CRThu/CarrotController/stm32h563_controller_firmware/stm32h563_controller管脚定义和说明.md

## 板上管脚分配 

### KEY/LED 

| NAME | PIN | DIR | PIN | 
| - | - | - | - |
| KEYA | PF10  | I | 22 | 
| LEDA | PF08  |  O | 20 | 
| LEDB | PF09  |  O | 21 | 
 
### UART 
| NAME | PIN | DIR | PIN | 
| - | - | - | - |
| UART4_TX  | PB9 | IO | 140 | 
| UART4_RX  | PB8 | IO | 139 | 
 
### SPI 
| NAME | PIN | DIR | PIN | FUNC | DEFAULT |
| - | - | - | - | - | - |
| SPI4_NSS1 | PE4 |  O | 3 | R98: ESP32-S3<br/>R113: APS6404(U7) | ESP32-S3  |
| SPI4_NSS2 | PE3 |  O | 2 | R114: APS6404(U8) | CATLINK |
| SPI4_SCK  | PE2 |  O | 1 | SHARED | |
| SPI4_MISO | PE5 | I | 4 | SHARED | |
| SPI4_MOSI | PE6 |  O | 5 | SHARED | |

### IIC 
| NAME | PIN | DIR | PIN | 
| - | - | - | - |
| I2C1_SCL  | PB6 | IO | 136 | 
| I2C1_SDA  | PB7 | IO | 137 | 

### MUX 
 
| NAME | PIN | DIR | PIN | FUNC | DEFAULT | 
| - | - | - | - | - | - |
| MUX_SEL01 | PB15  |  O | 76 | BTB_CLK1 - MCU_PA01 | H | 
| MUX_SEL02 | PA08  |  O | 100 | BTB_CLK1 - SI5351_PLL1 | L | 
| MUX_SEL03 | PC09  |  O | 99 | BTB_CLK2 - MCU_PB03(SPI1_SCK) | L | 
| MUX_SEL04 | PC08  |  O | 98 | BTB_SPIA_SCK - MCU_PB03(SPI1_SCK) | H | 
| MUX_SEL05 | PB13  |  O | 74 | MCU_PB03(SPI1_SCK) - MCU_PC10(SPI3_SCK) | L | 
| MUX_SEL06 | PB14  |  O | 75 | BTB_SPIB_SCK - MCU_PC10(SPI3_SCK) | H | 
| MUX_SEL07 | PC05  |  O | 45 | BTB_CLK3 - MCU_PC02 | H | 
| MUX_SEL08 | PA05  |  O | 41 | BTB_CLK3 - SI5351_PLL2 | L | 
| MUX_SEL09 | PC13  |  O | 7 | BTB_CLK4 - MCU_PC03 | H | 
| MUX_SEL10 | PE00  |  O | 141 | BTB_CLK4 - SI5351_PLL3 | L | 
| MUX_SEL11 | PC15  |  O | 9 | BTB_CLK5 - MCU_PA02 | H | 
| MUX_SEL12 | PC14  |  O | 8 | BTB_CLK6 - MCU_PA03 | H | 
 
### FTDI 
 
| NAME | PIN | DIR | PIN | 
| - | - | - | - |
| FT_D0 | PF00  | IO | 10 | 
| FT_D1 | PF01  | IO | 11 | 
| FT_D2 | PF02  | IO | 12 | 
| FT_D3 | PF03  | IO | 13 | 
| FT_D4 | PF04  | IO | 14 | 
| FT_D5 | PF05  | IO | 15 | 
| FT_D6 | PF06  | IO | 18 | 
| FT_D7 | PF07  | IO | 19 | 
| FT_RDN	| PF13  |  O | 53 | 
| FT_RXFN	| PF11  | I | 49 | 
| FT_SIWUA	| PF15  |  O | 55 | 
| FT_TXEN	| PF12  | I | 50 | 
| FT_WRN	| PF14  |  O | 54 | 
 
## BTB管脚分配 
| BTB NAME | PIN | MCU PIN |
| - | - | - |
| CLK1	 | 11 | PA01* |
| CLK2	 | 13 | PA00 |
| CLK3	 | 12 | PC02* |
| CLK4	 | 14 | PC03* |
| CLK5	 | 18 | PA02* |
| CLK6	 | 20 | PA03* |
| SPIA_NSS/CS0  | 17 | PA04 |
| SPIA_SCK | 23 | PB03* |
| SPIA_MOSI | 25 | PB05 |
| SPIA_MISO | 27 | PB04 |
| SPIB_NSS/CS1  | 19 | PA15 |
| SPIB_SCK | 24 | PC10* |
| SPIB_MOSI | 26 | PC12 |
| SPIB_MISO | 28 | PC11 |
| CS2 | 32 | PC06 |
| CS3 | 31 | PC07 |
| D00 | 34 | PD00 |
| D01 | 36 | PD01 |
| D02 | 38 | PD02 |
| D03 | 40 | PD03 |
| D04 | 42 | PD04 |
| D05 | 44 | PD05 |
| D06 | 46 | PD06 |
| D07 | 48 | PD07 |
| D08 | 33 | PD08 |
| D09 | 35 | PD09 |
| D10 | 37 | PD10 |
| D11 | 39 | PD11 |
| D12 | 41 | PD12 |
| D13 | 43 | PD13 |
| D14 | 45 | PD14 |
| D15 | 47 | PD15 |
| RDL | 50 | PE13 |
| WRL | 52 | PE15 |
| RDH | 49 | PE12 |
| WRH | 51 | PE14 |
| UART_TXD | 55 | PA09 |
| UART_RXD | 57 | PA10 |
| IIC_SDA | 56 | PB12 |
| IIC_SCL | 58 | PB10 |
