CRThu/CarrotController/PCB/PCB.stm32h563_controller_mini.Ver.A.pdf

# R48 R⁴⁹

# R261 R²⁶²

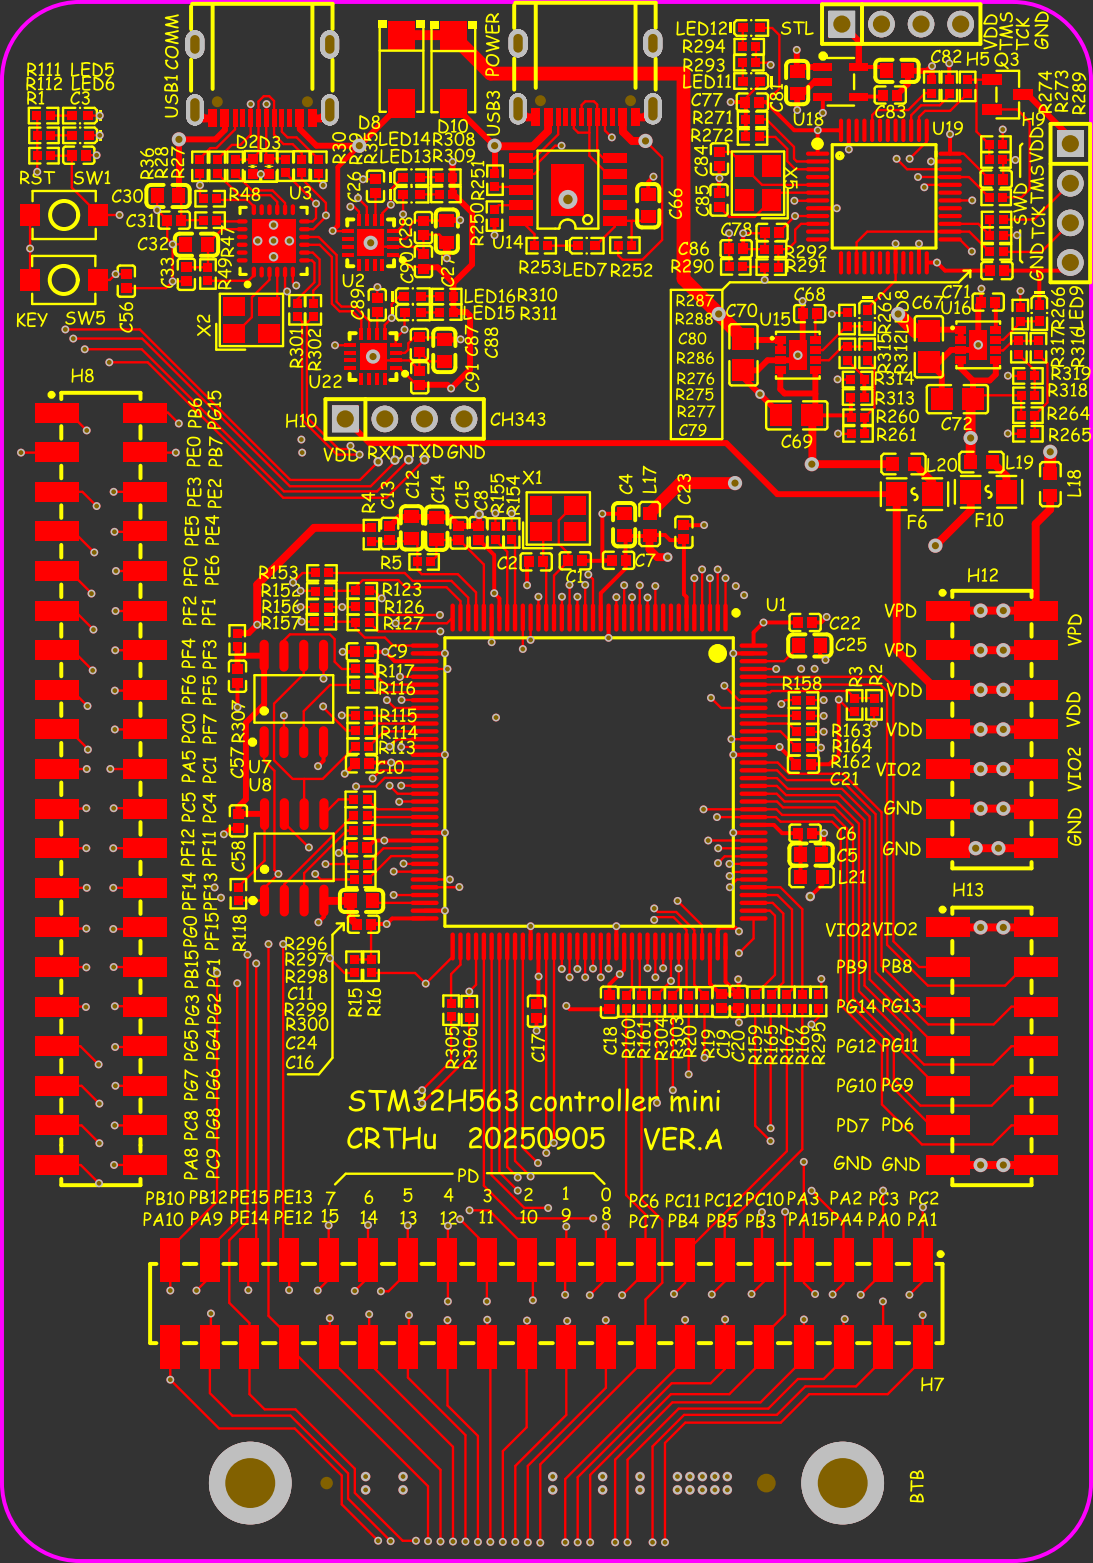
[picture p1: page 1]

VDD TMS TCK GND

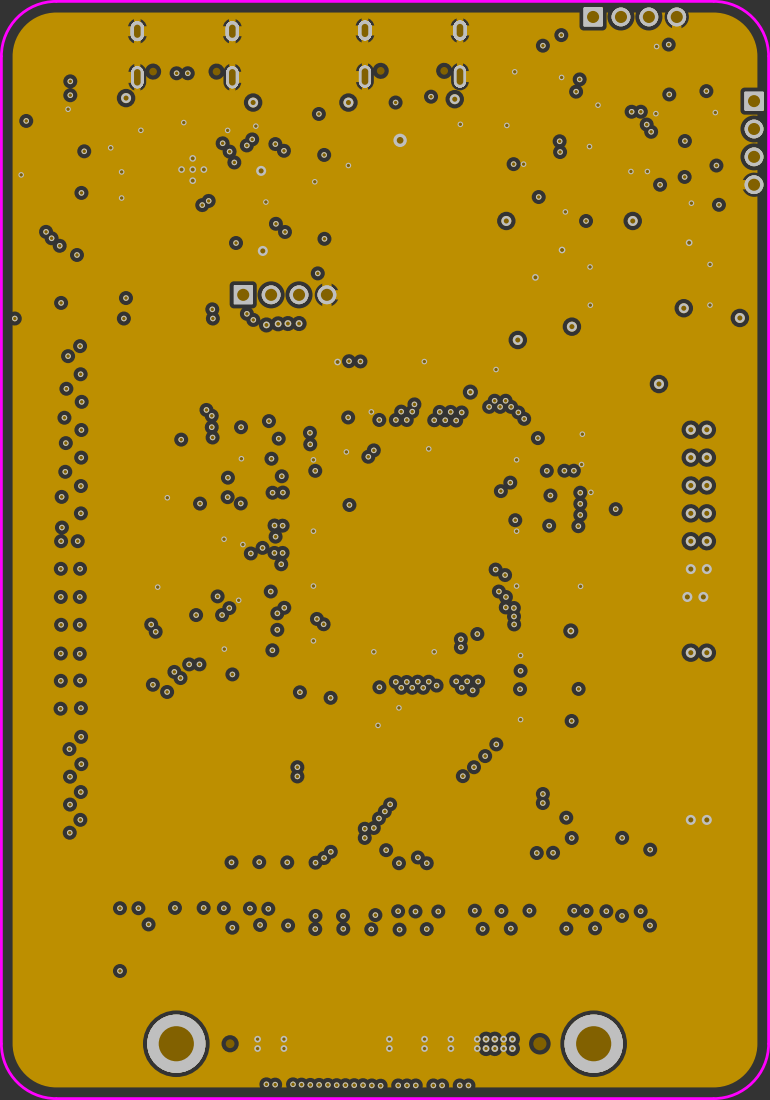
[picture p2: page 2]

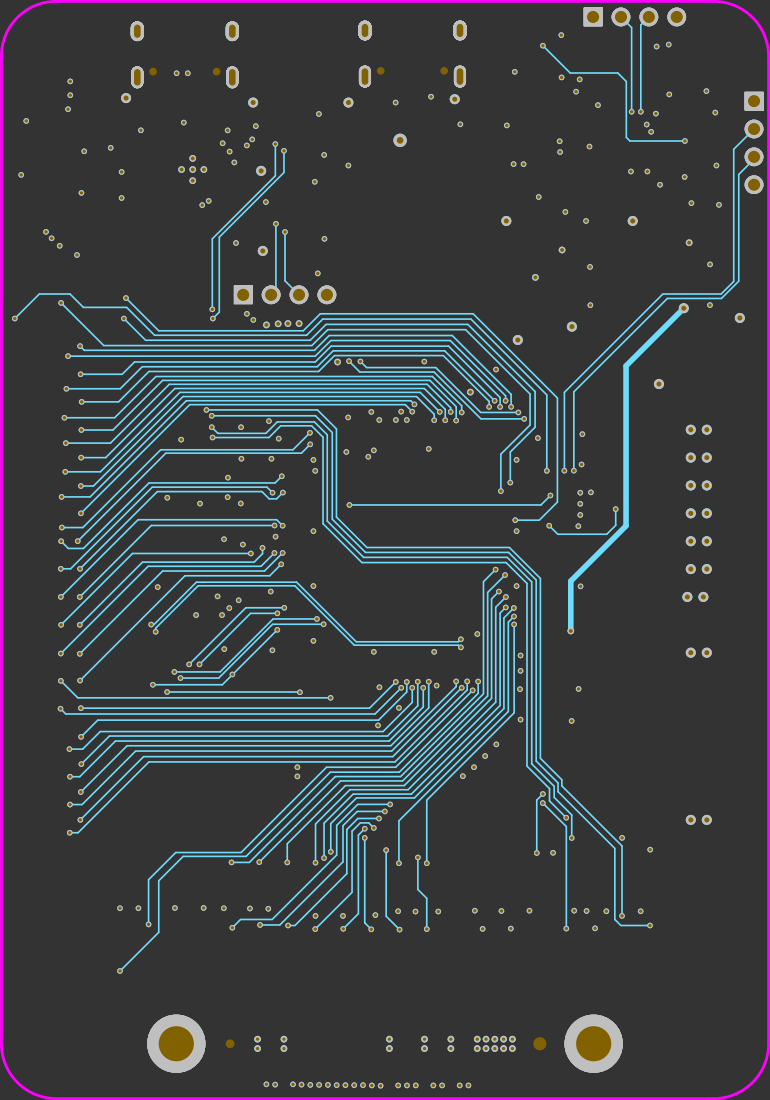
[picture p3: page 3]

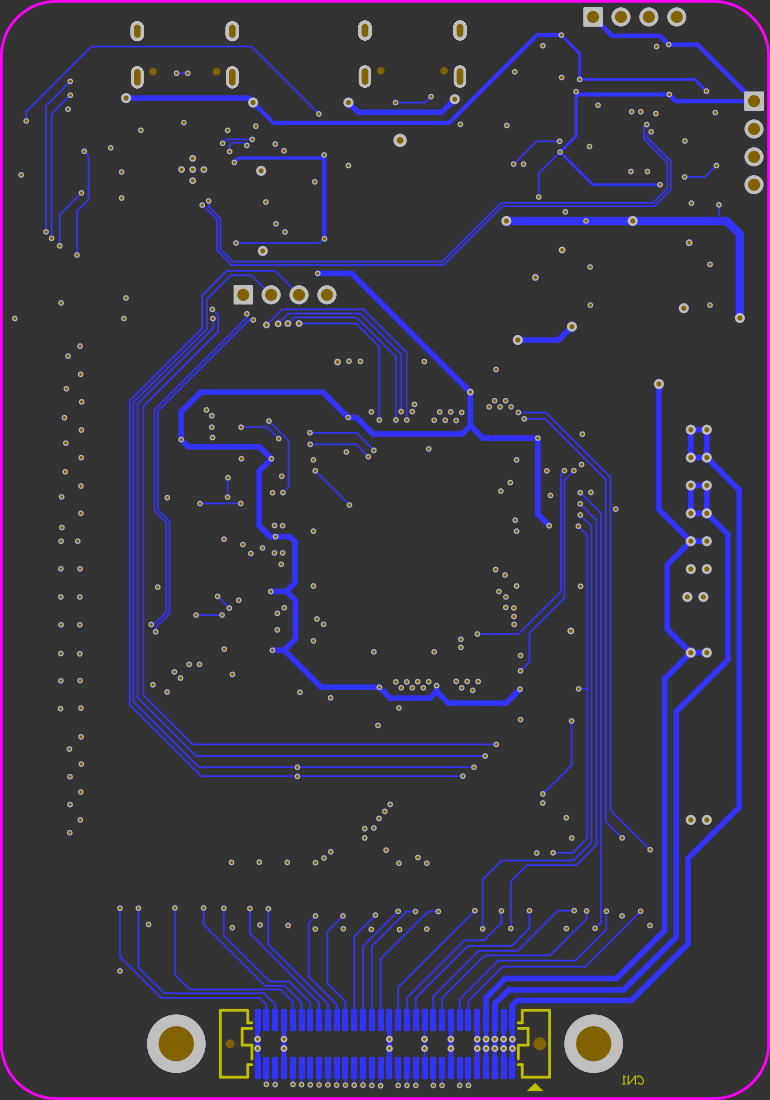
[picture p4: page 4]
