CRThu/CarrotController/PCB/SCH.stm32h563_controller.Ver.A.pdf

PD15 86 PD14 85 PD13 82 PD12 81 PD11 80 PD10 79 PD9 78 PD8 77 PD7 123 PD6 122 PD5 119 PD4 118 PD3 117 PD2 116 PD1 115 PD0 114

PA15 110 PA14 109 PA13 105 PA12 104 PA11 103 PA10 102 PA9 101 PA8 100 PA7 43 PA6 42 PA5 41 PA4 40 PA3 37 PA2 36 PA1 35 PA0 34

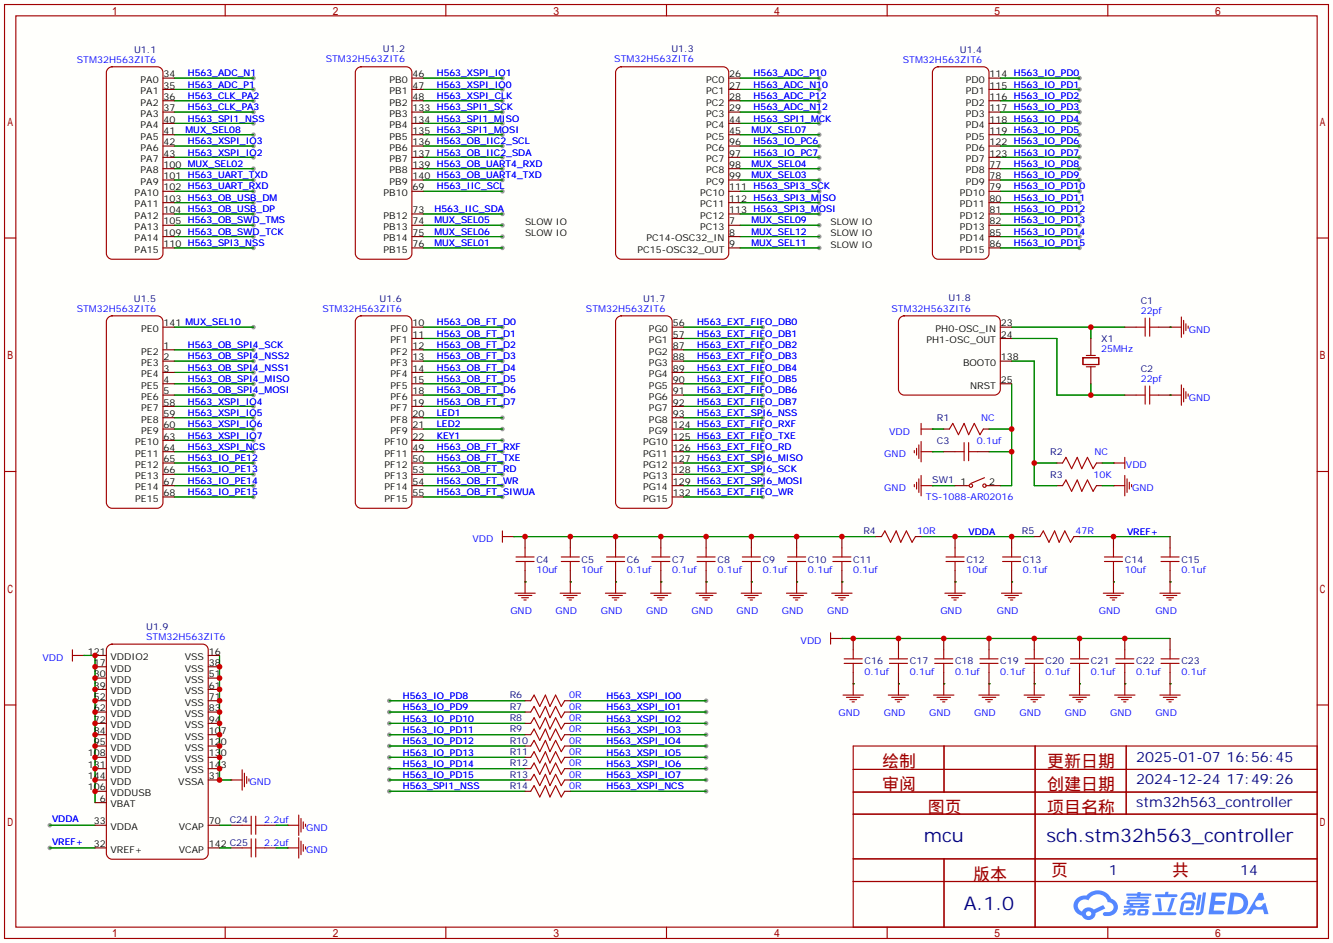
[picture p5: page 1]

STM32H563ZIT6
VDDUSB 106 VDD 144 VDD 131 VDD 108 VDD 95 VDD 84 VDD 72 VDD 62 VDD 52 VDD 39 VDD 30 VDD 17

图页 | 项目名称 | stm32h563_controller
mcu | sch.stm32h563_controller

版本 | 页 共
A.1.0

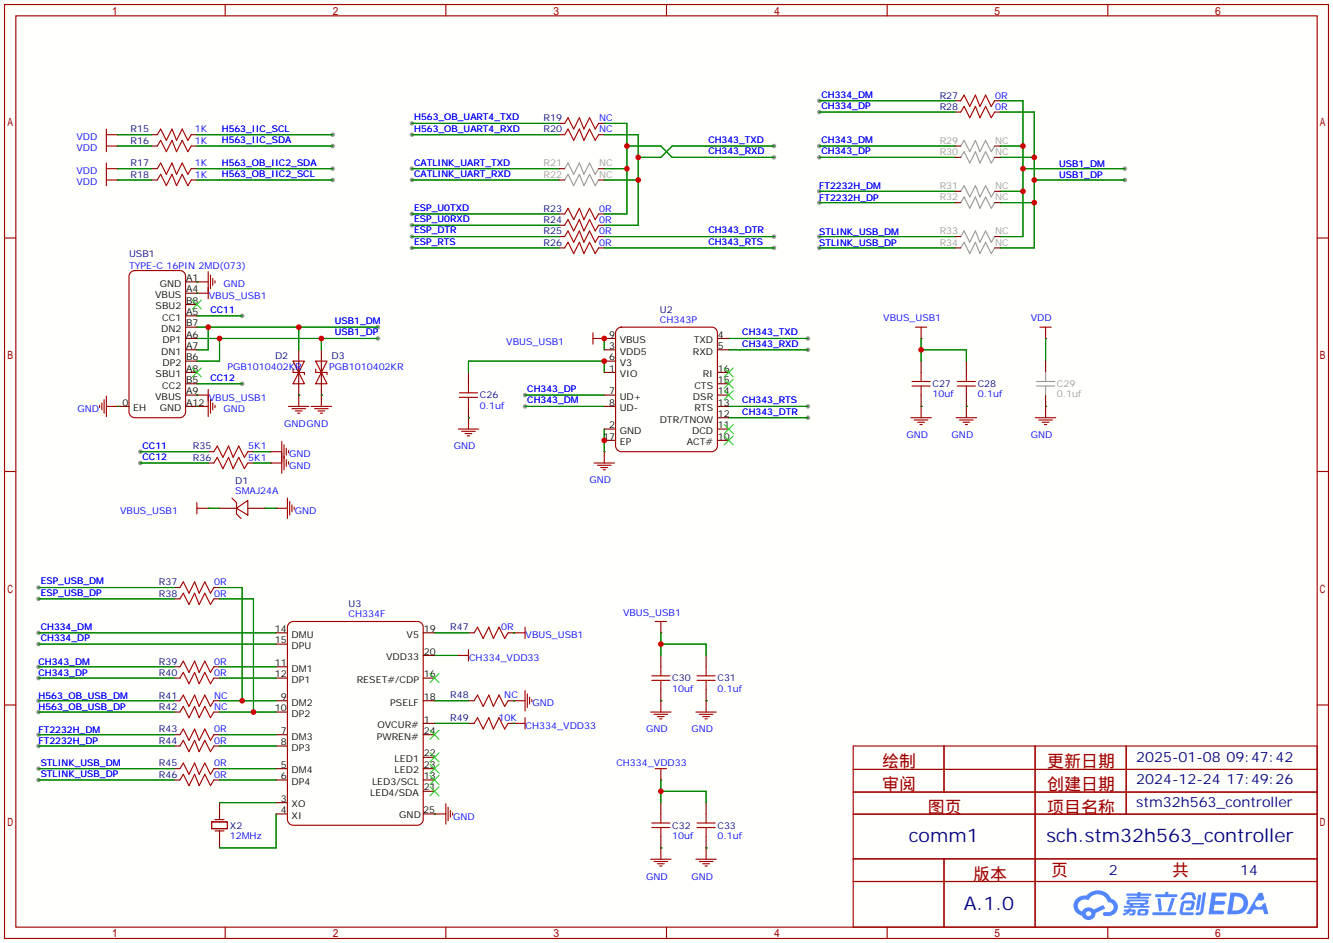
[picture p6: page 2]

ACT# 10 DCD 11 DTR/TNOW 12 RTS 13 DSR 14 CTS 15 RI 16

绘制 | 更新日期 | 2025-01-08 09:47:42
审阅 | 创建日期 | 2024-12-24 17:49:26
图页 | 项目名称 | stm32h563_controller
comm1 | sch.stm32h563_controller

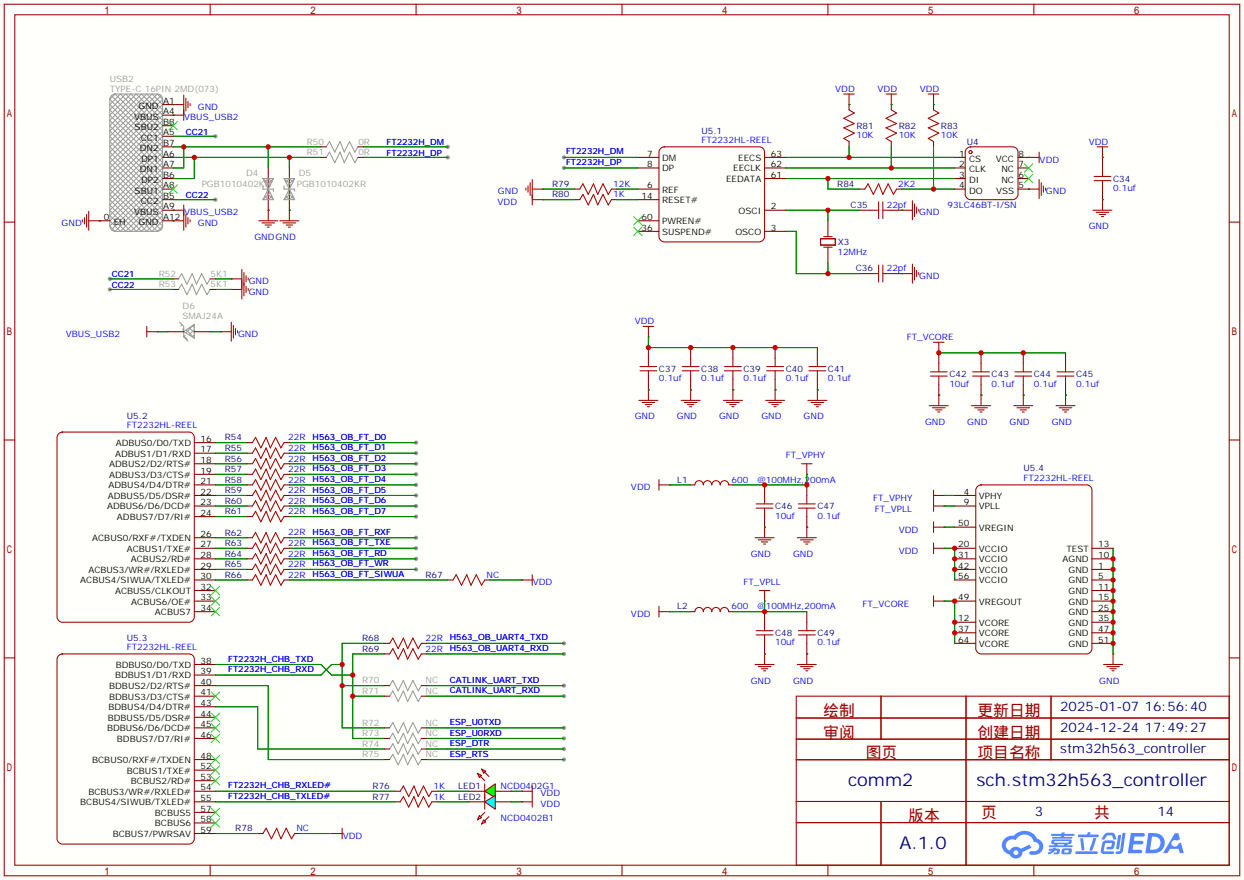
[picture p7: page 3]

绘制 | 更新日期 | 2025-01-07 16:56:40
审阅 | 创建日期 | 2024-12-24 17:49:27
图页 | 项目名称 | stm32h563_controller
comm2 | sch.stm32h563_controller

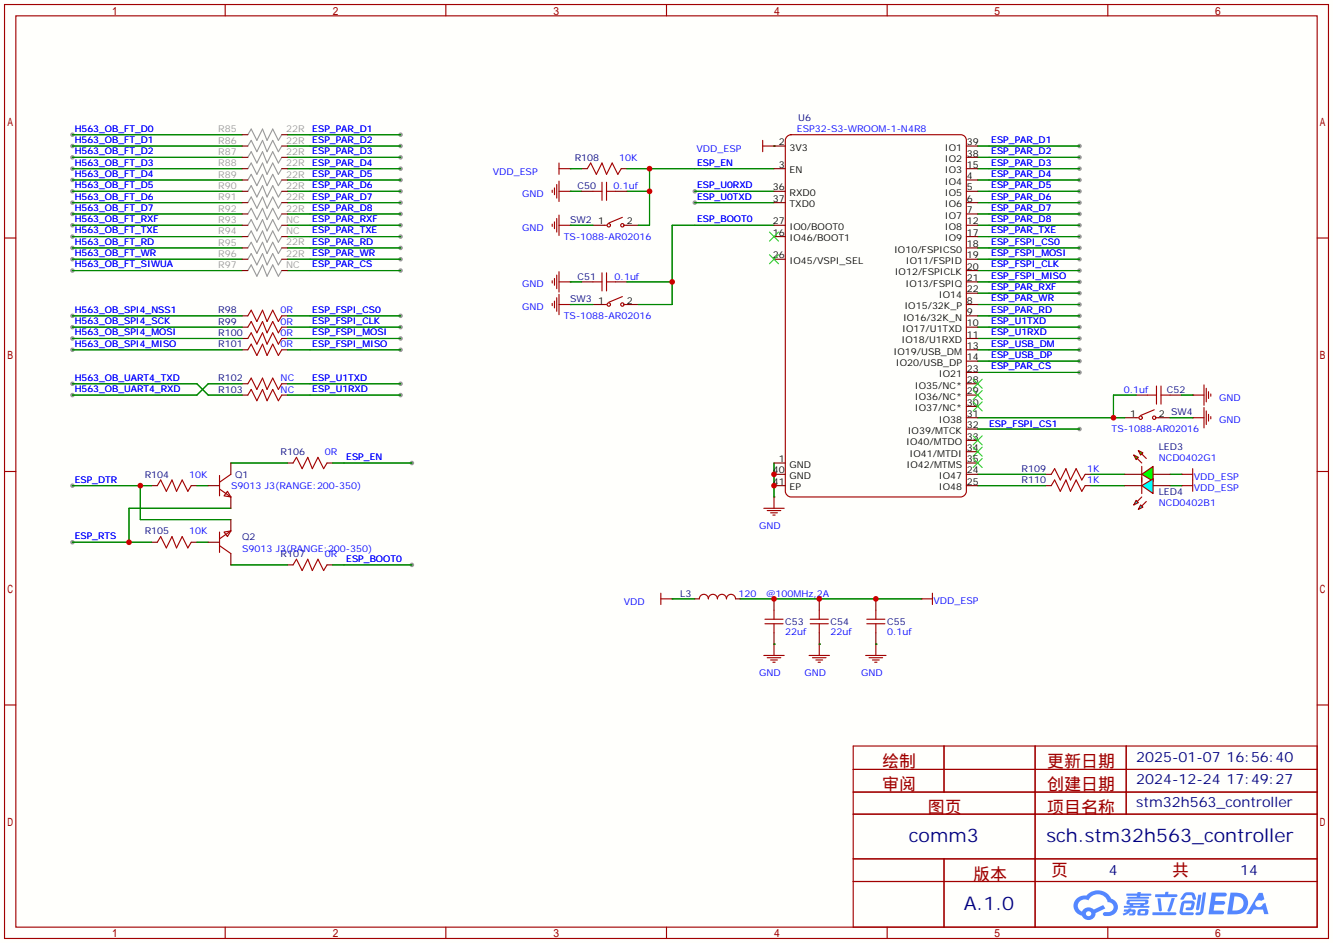
[picture p8: page 4]

绘制 | 更新日期 | 2025-01-07 16:56:40
审阅 | 创建日期 | 2024-12-24 17:49:27
图页 | 项目名称 | stm32h563_controller
comm3 | sch.stm32h563_controller

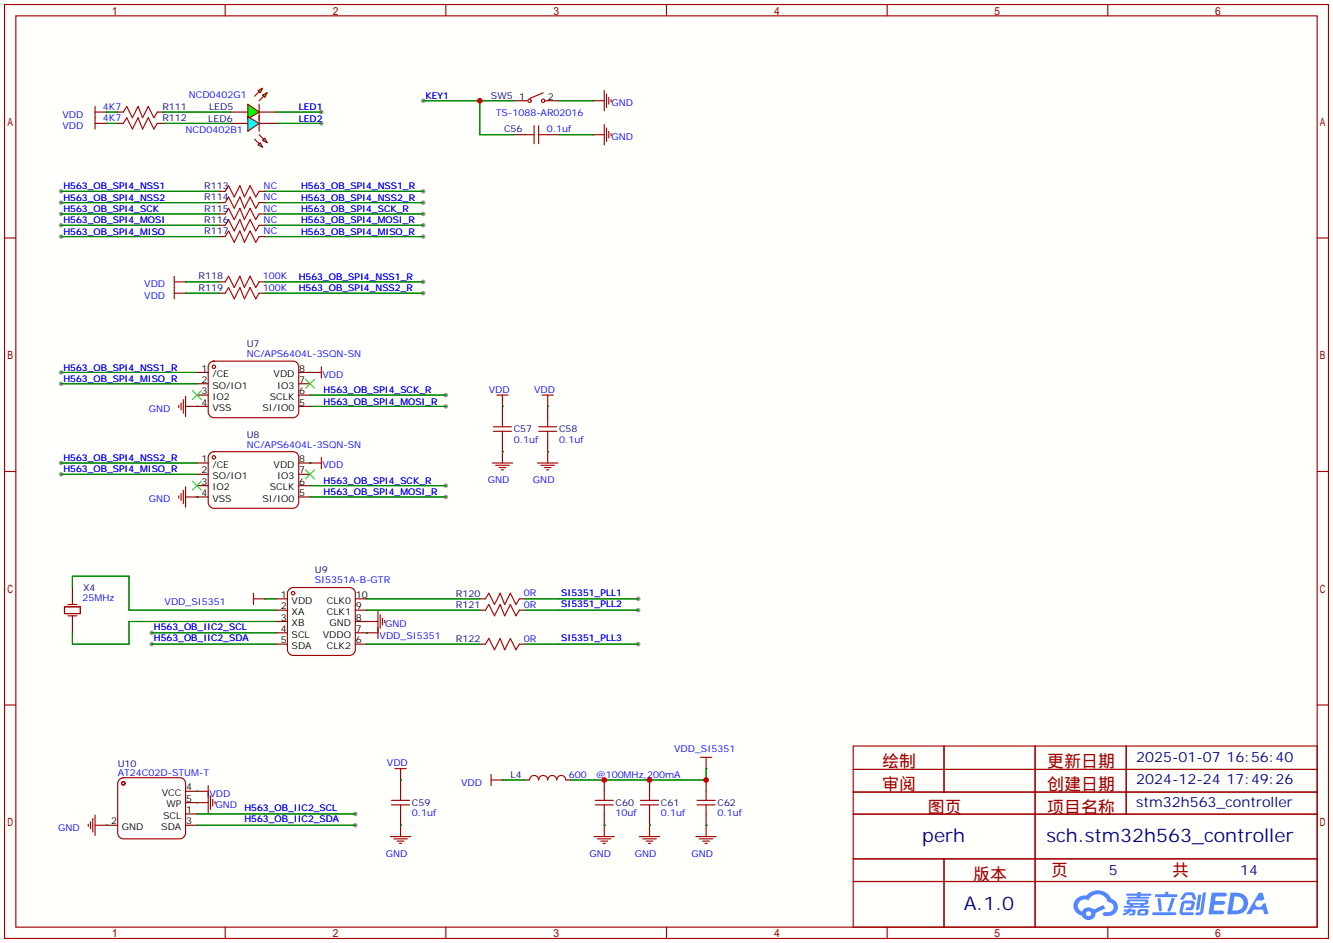
[picture p9: page 5]

绘制 | 更新日期 | 2025-01-07 16:56:40
审阅 | 创建日期 | 2024-12-24 17:49:26
图页 | 项目名称 | stm32h563_controller
perh | sch.stm32h563_controller

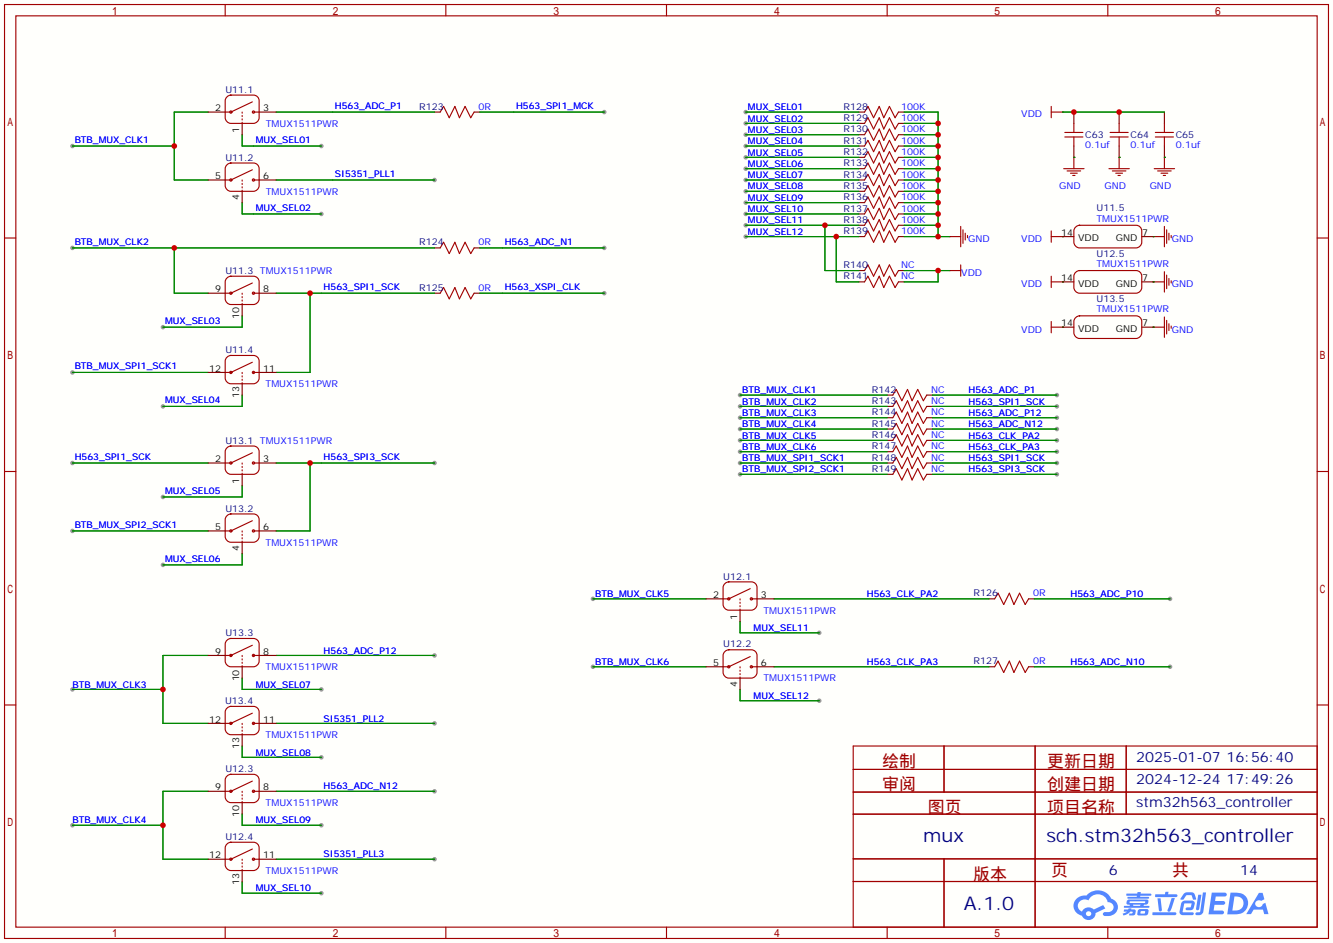
[picture p10: page 6]

绘制 | 更新日期 | 2025-01-07 16:56:40
审阅 | 创建日期 | 2024-12-24 17:49:26
图页 | 项目名称 | stm32h563_controller
mux | sch.stm32h563_controller

# TestLink to DUT1

## BTB-V03.2-莫斯卡

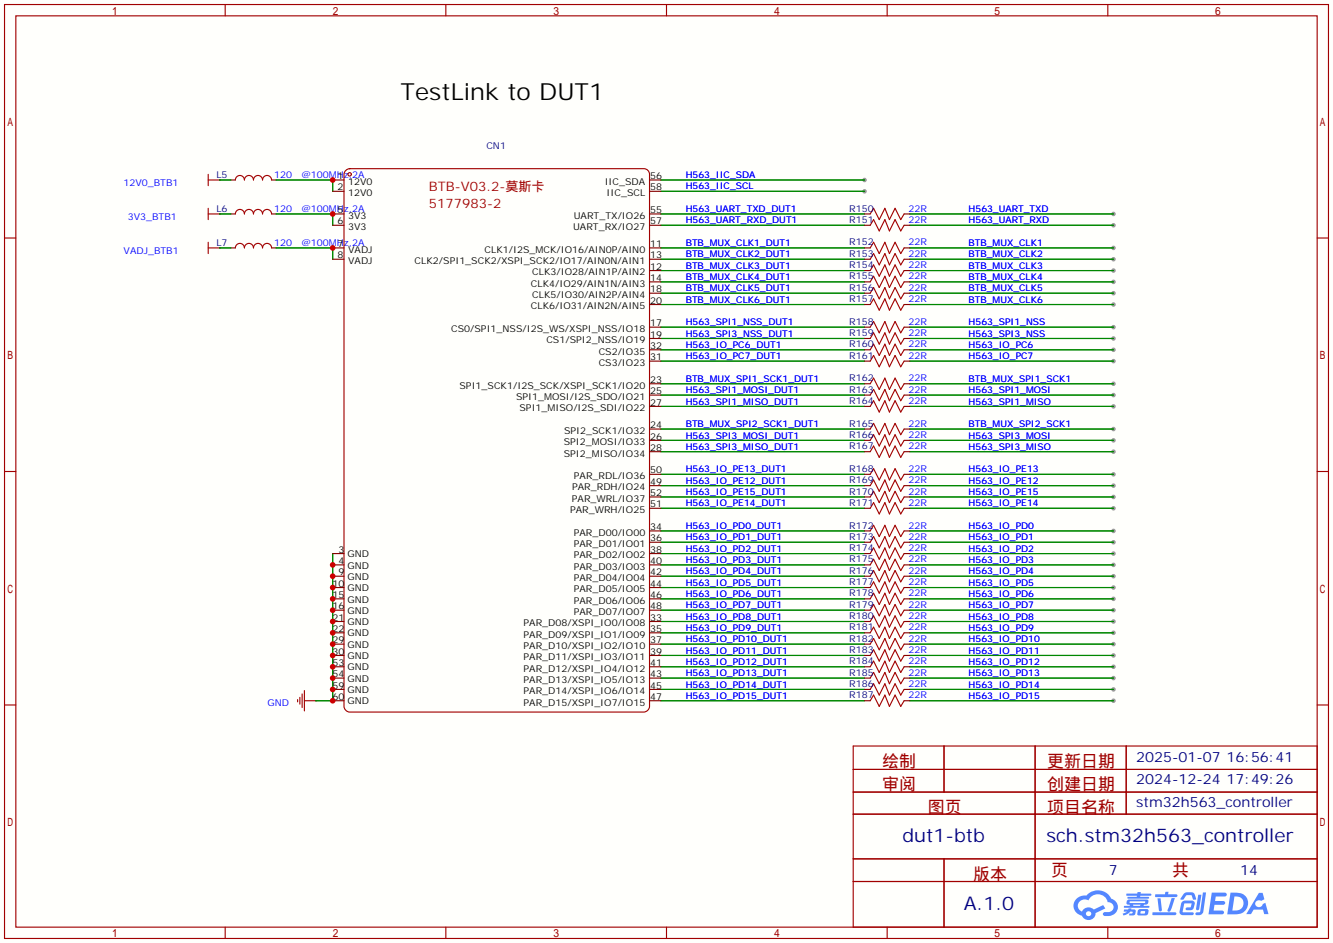
[picture p11: page 7]

绘制 | 更新日期 | 2025-01-07 16:56:41
审阅 | 创建日期 | 2024-12-24 17:49:26
图页 | 项目名称 | stm32h563_controller
dut1-btb | sch.stm32h563_controller

# TestLink to DUT2

## BTB-V03.2-莫斯卡

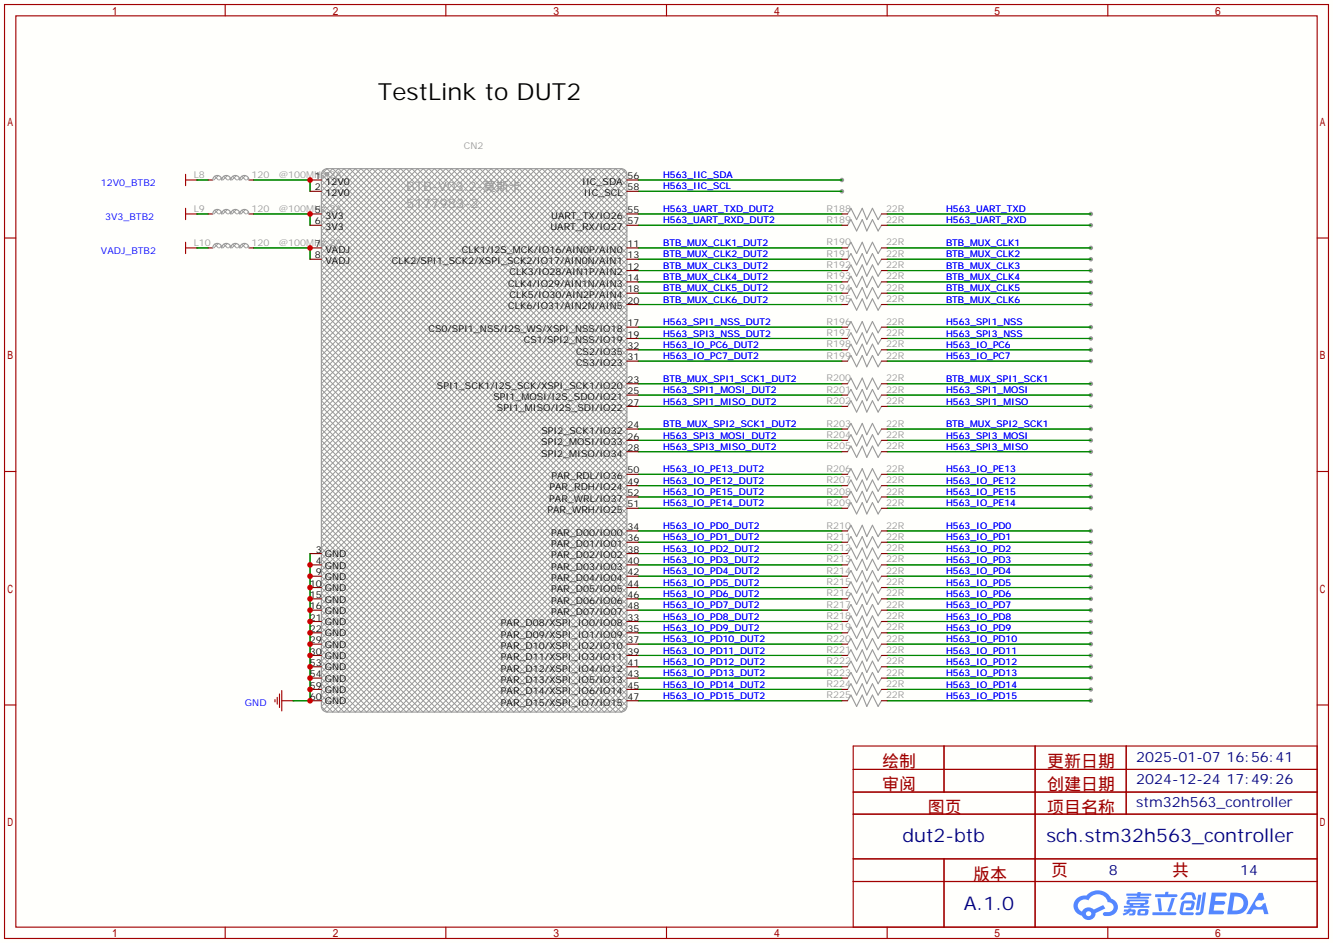
[picture p12: page 8]

绘制 | 更新日期 | 2025-01-07 16:56:41
审阅 | 创建日期 | 2024-12-24 17:49:26
图页 | 项目名称 | stm32h563_controller
dut2-btb | sch.stm32h563_controller

# TestLink to CoProc

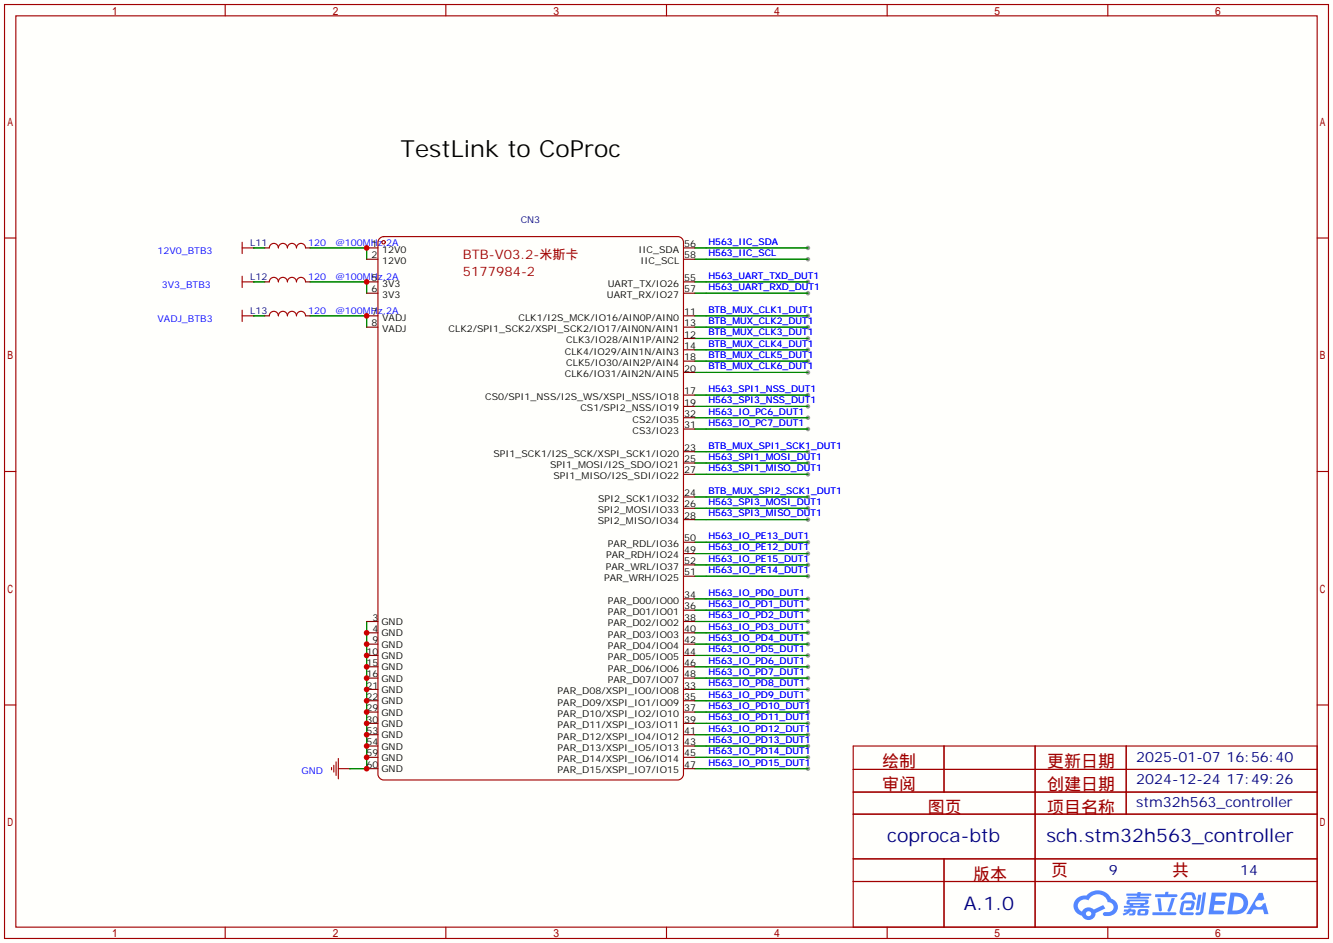
[picture p13: page 9]

绘制 | 更新日期 | 2025-01-07 16:56:40
审阅 | 创建日期 | 2024-12-24 17:49:26
图页 | 项目名称 | stm32h563_controller
coproca-btb | sch.stm32h563_controller

# CatLink to CoProc

## BTB-V03.2-米斯卡

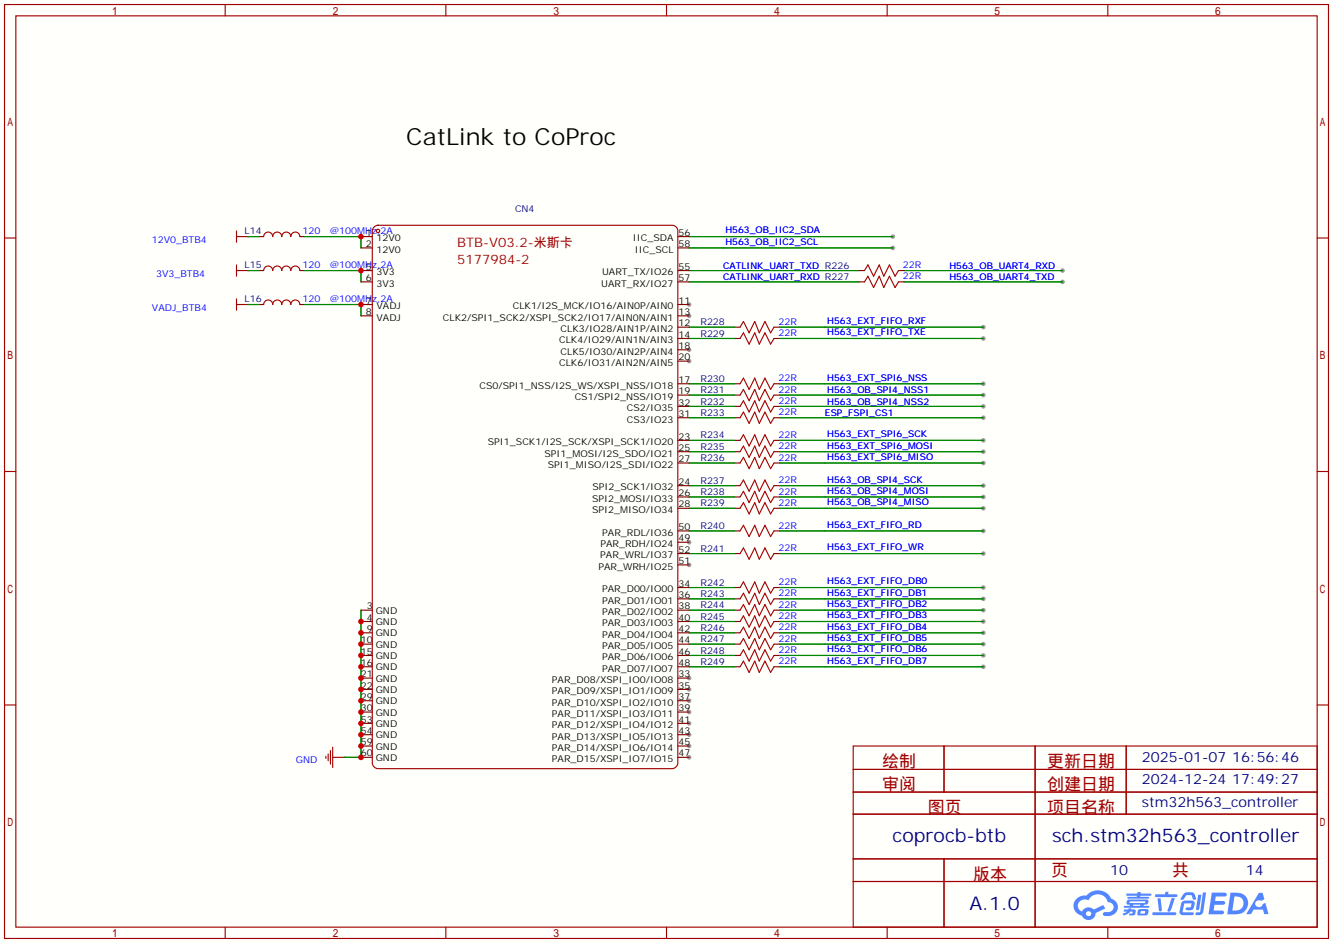
[picture p14: page 10]

绘制 | 更新日期 | 2025-01-07 16:56:46
审阅 | 创建日期 | 2024-12-24 17:49:27
图页 | 项目名称 | stm32h563_controller
coprocb-btb | sch.stm32h563_controller

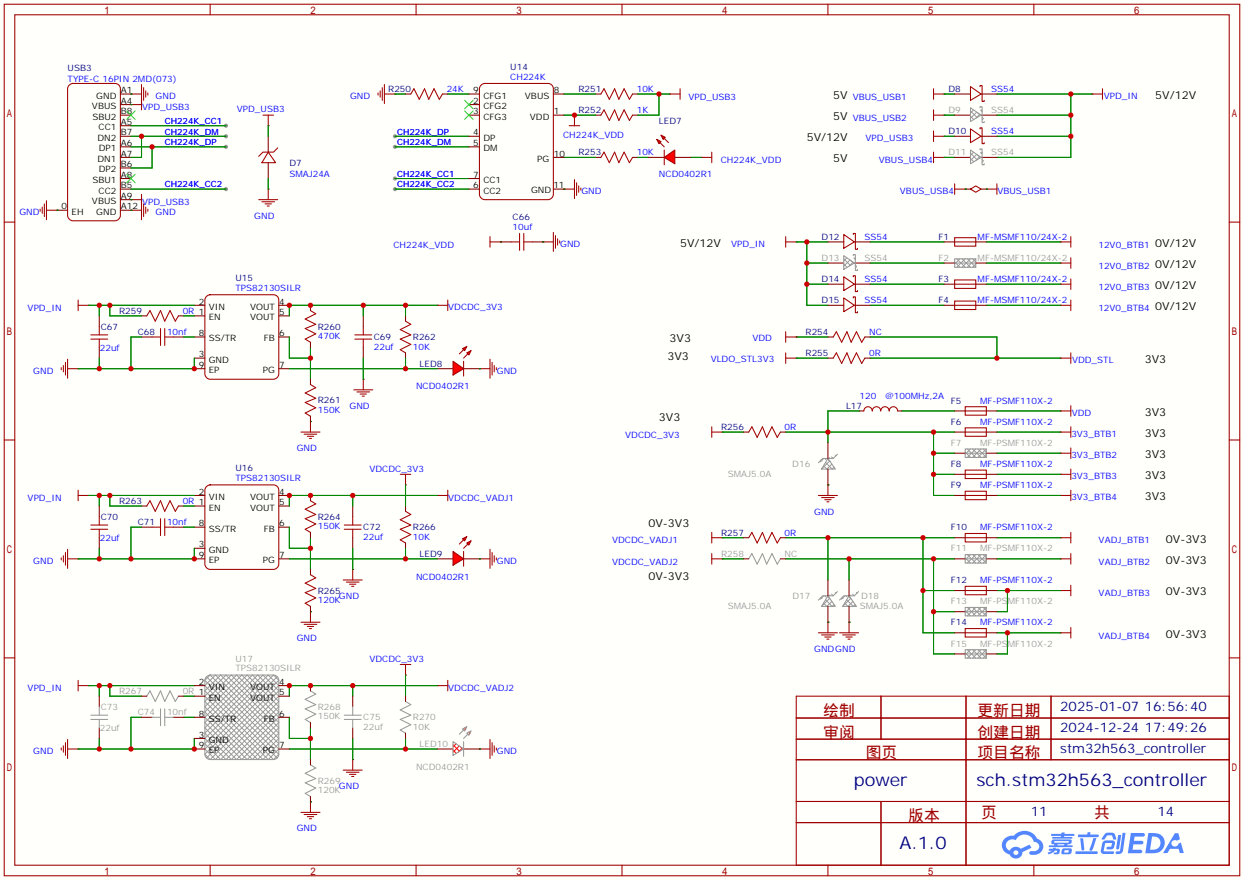
[picture p15: page 11]

绘制 | 更新日期 | 2025-01-07 16:56:40
审阅 | 创建日期 | 2024-12-24 17:49:26
图页 | 项目名称 | stm32h563_controller
power | sch.stm32h563_controller

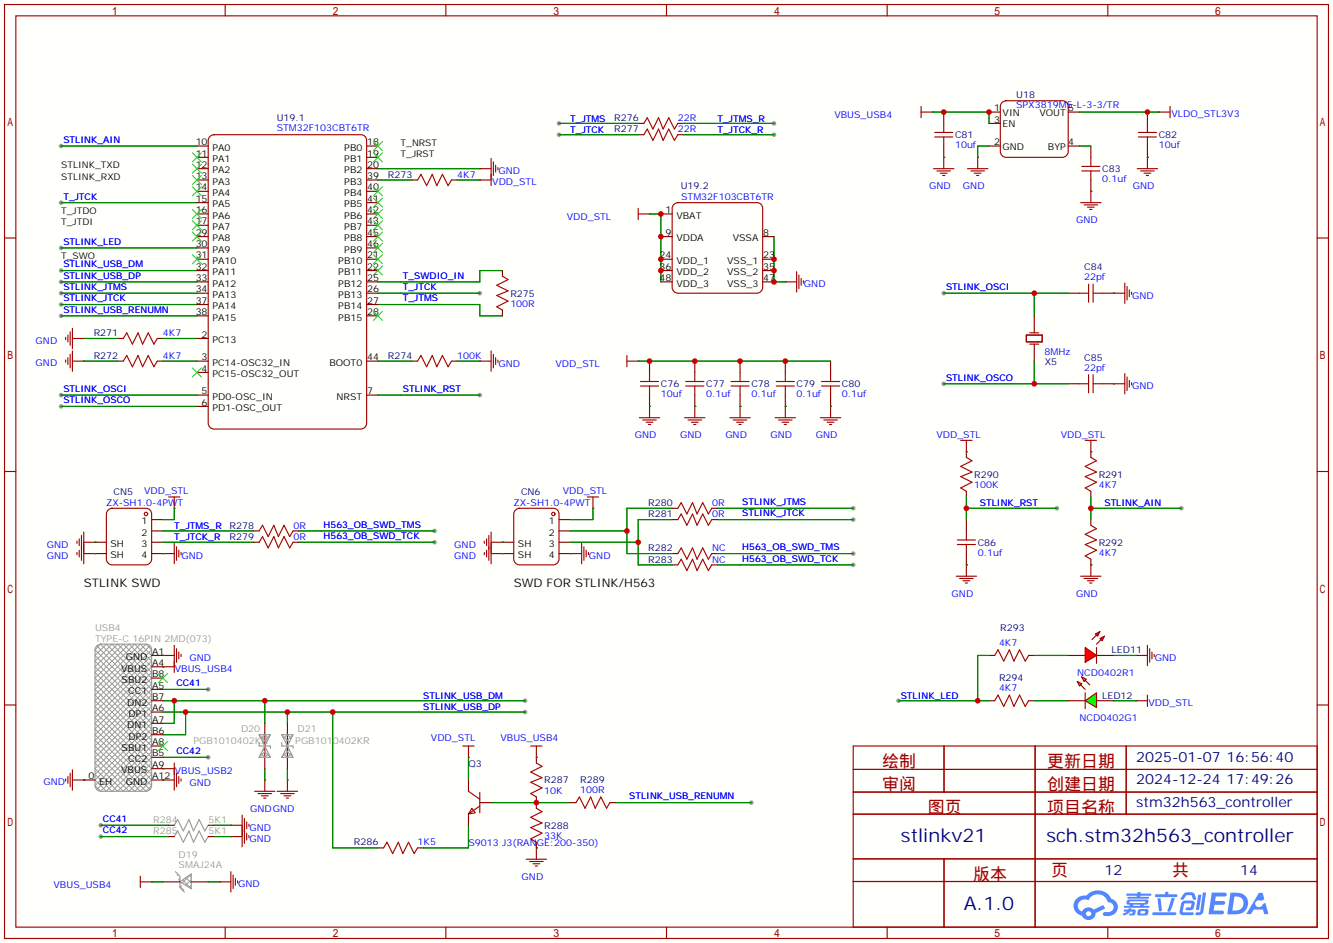
[picture p16: page 12]

绘制 | 更新日期 | 2025-01-07 16:56:40
审阅 | 创建日期 | 2024-12-24 17:49:26
图页 | 项目名称 | stm32h563_controller
stlinkv21 | sch.stm32h563_controller

绘制 | 更新日期 | 2025-01-07 16:56:38
审阅 | 创建日期 | 2024-12-25 20:59:03
图页 | 项目名称 | stm32h563_controller
P1 | sch.stm32h563_controller

## USB3

## USB1

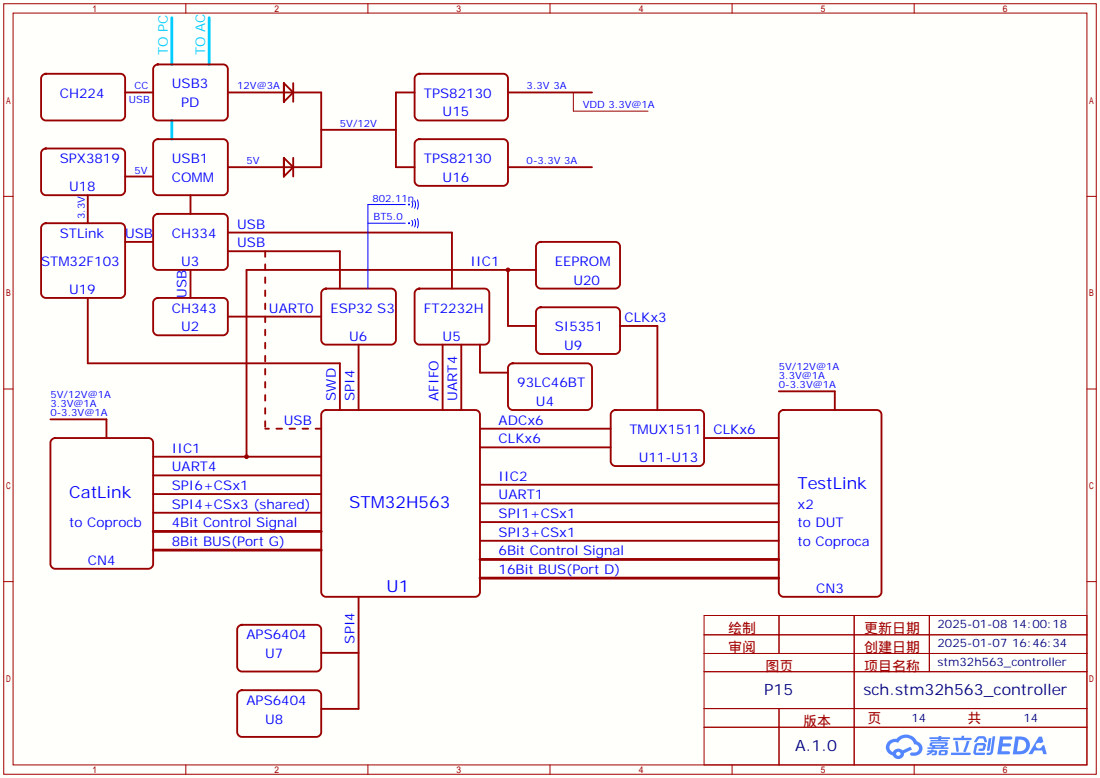
[picture p17: page 14]

绘制 | 更新日期 | 2025-01-08 14:00:18
审阅 | 创建日期 | 2025-01-07 16:46:34
图页 | 项目名称 | stm32h563_controller
P15 | sch.stm32h563_controller
