CRThu/CarrotController/PCB/SCH.stm32h563_controller_mini.Ver.A.pdf

PA15 110 PA14 109 PA13 105 PA12 104 PA11 103 PA10 102 PA9 101 PA8 100 PA7 43 PA6 42 PA5 41 PA4 40 PA3 37 PA2 36 PA1 35 PA0 34

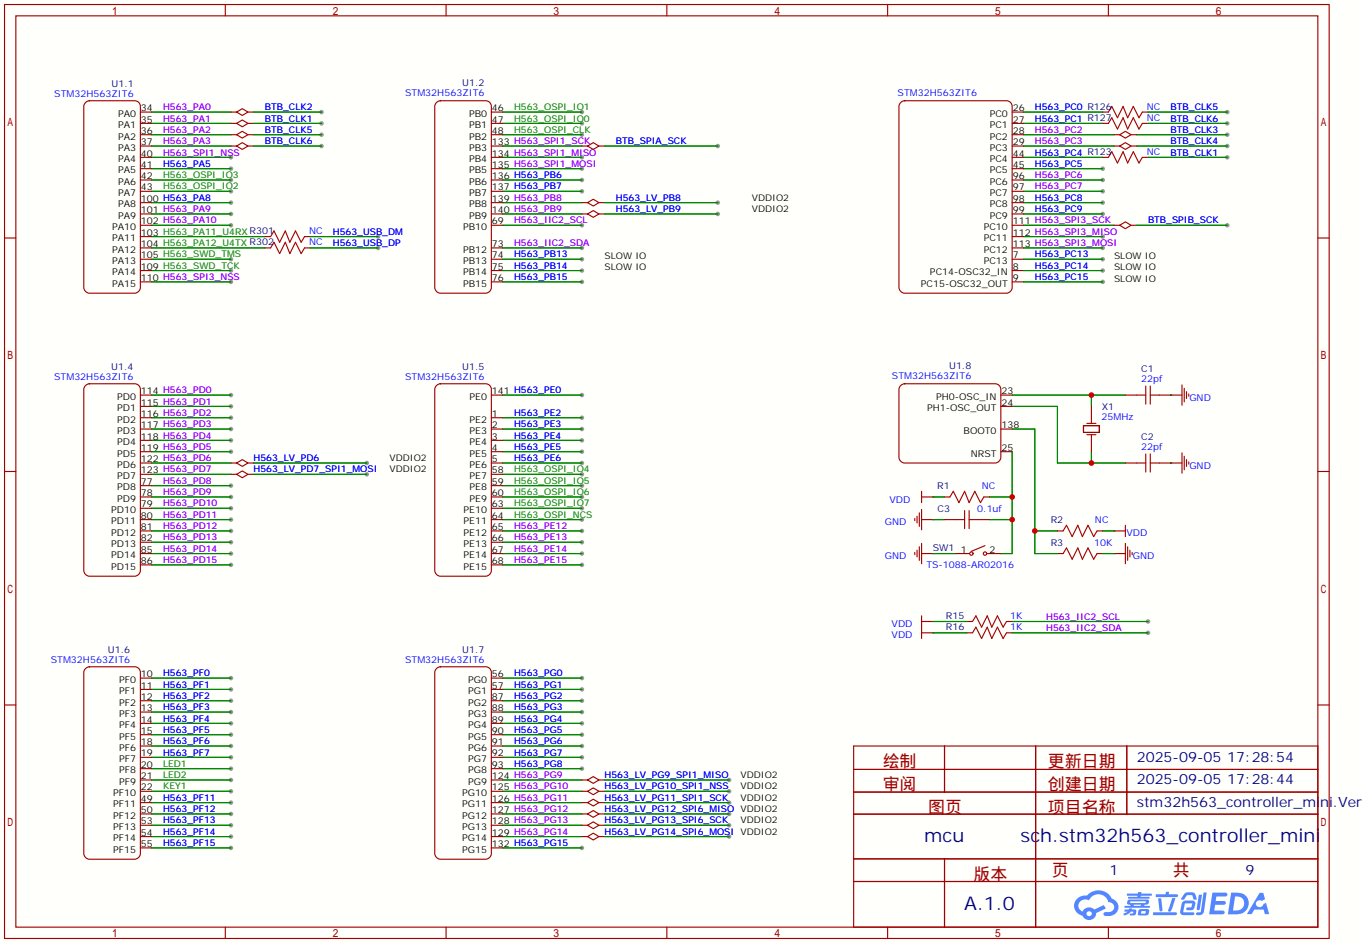
[picture p18: page 1]

绘制 | | 更新日期 | 2025-09-05 17:28:54
审阅 | | 创建日期 | 2025-09-05 17:28:44
图页 | | 项目名称
mcu sch.stm32h563_controller_mini

版本 | 页 共
A.1.0

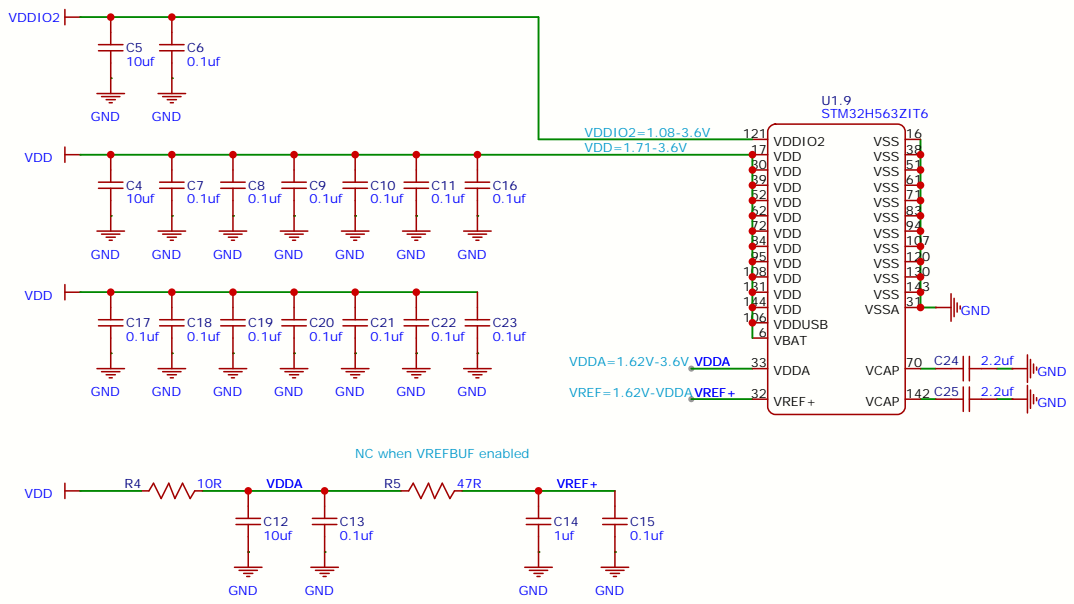
[picture p19: page 2]

STM32H563ZIT6
VDDUSB 106 VDD 144 VDD 131 VDD 108 VDD 95 VDD 84 VDD 72 VDD 62 VDD 52 VDD 39 VDD 30 VDD 17

NC when VREFBUF enabled

绘制 | 更新日期 | 2025-09-05 17:28:54
审阅 | 创建日期 | 2025-09-05 17:28:44
图页 | 项目名称
mcu_power sch.stm32h563_controller_mini

PSRAM | LED/KEY

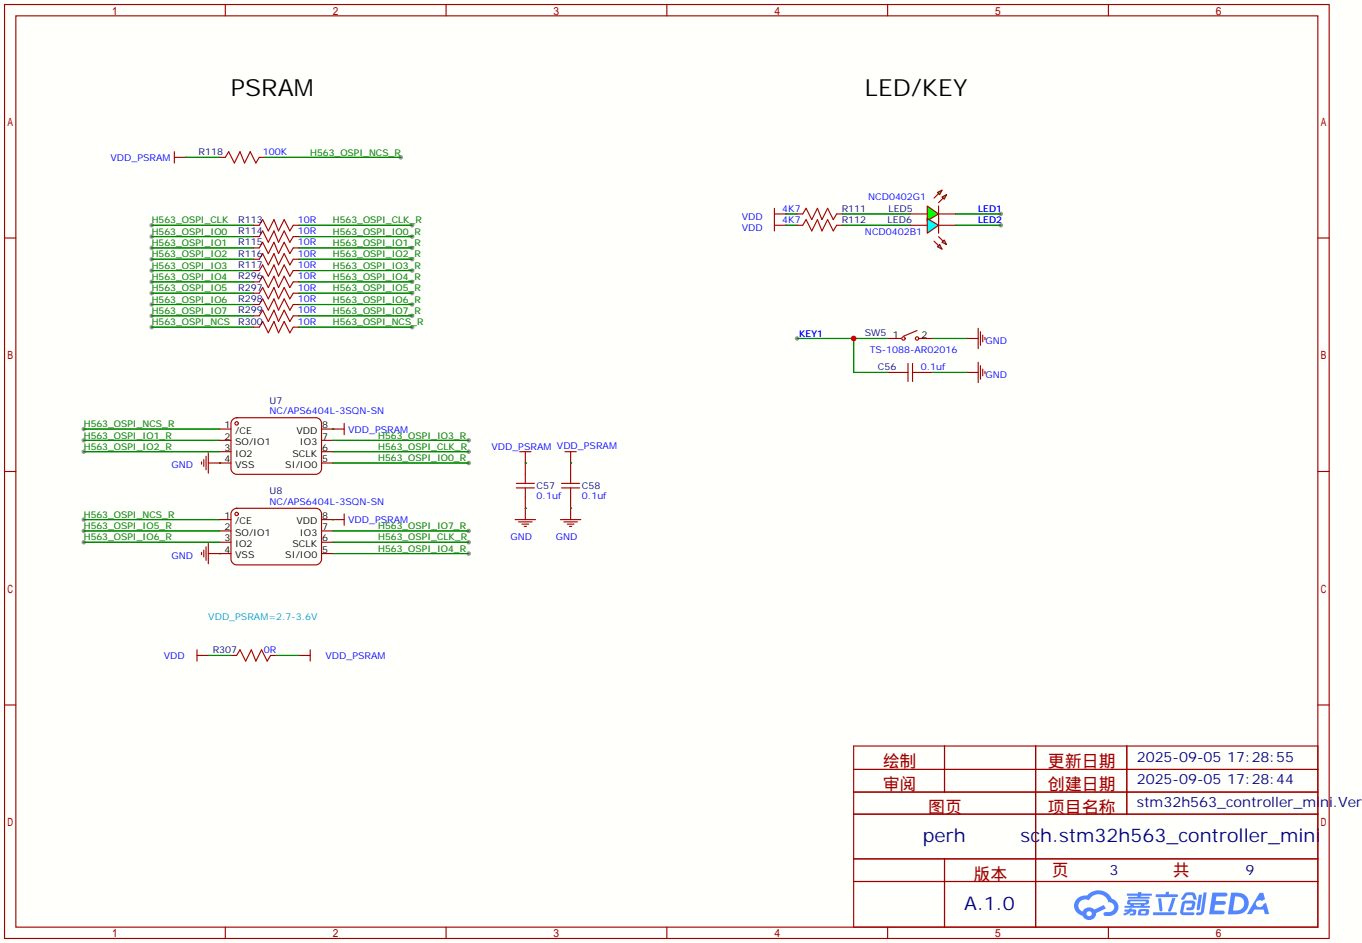
[picture p20: page 3]

绘制 | 更新日期 | 2025-09-05 17:28:55
审阅 | 创建日期 | 2025-09-05 17:28:44
图页 | 项目名称
perh sch.stm32h563_controller_mini

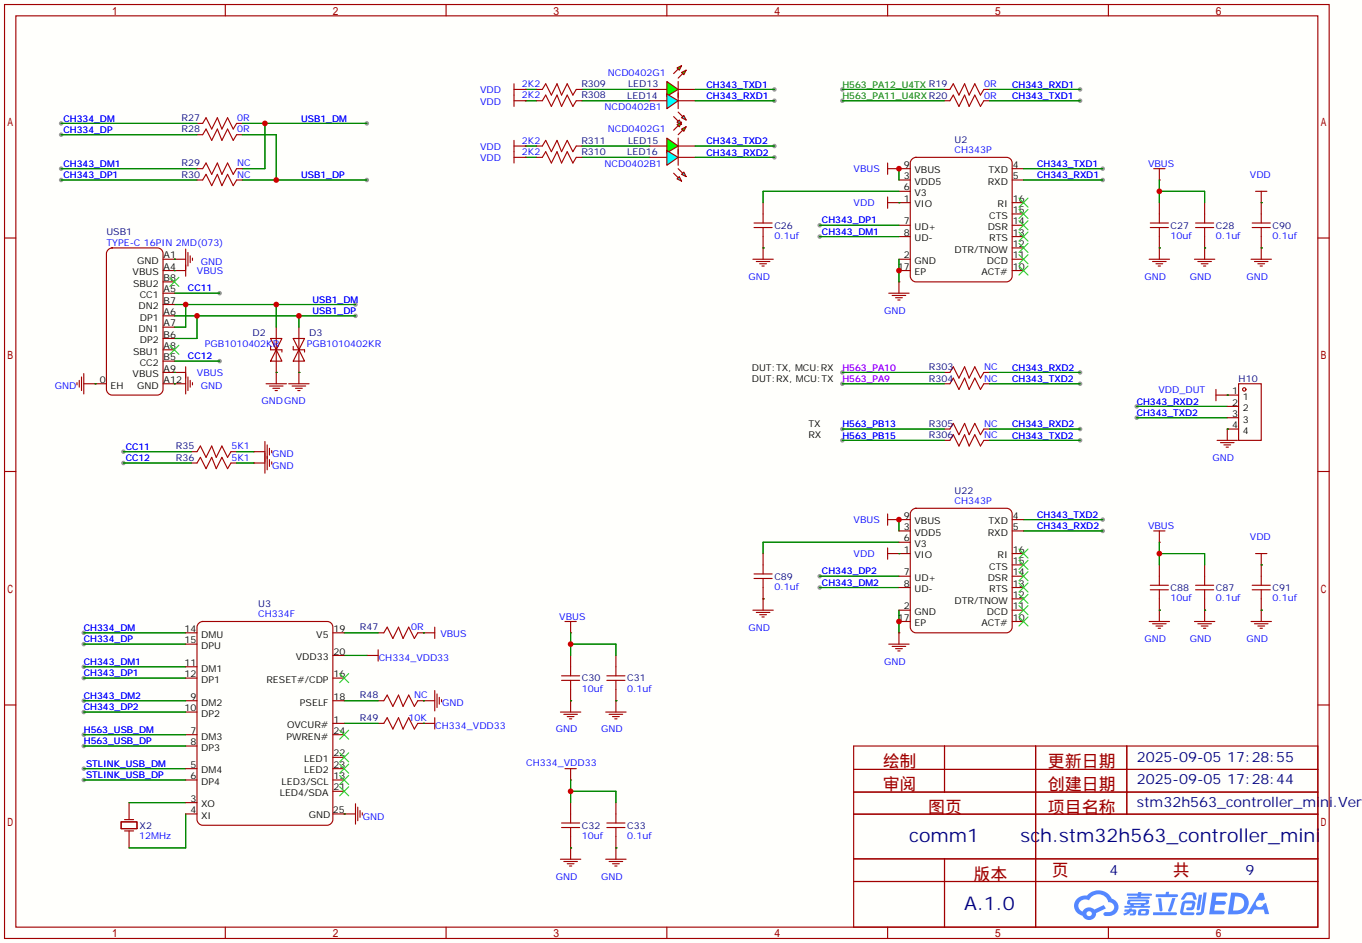
[picture p21: page 4]

ACT# 10 DCD 11 DTR/TNOW 12 RTS 13 DSR 14 CTS 15 RI 16

DUT:TX, MCU:RX
DUT:RX, MCU:TX

绘制 | 更新日期 | 2025-09-05 17:28:55
审阅 | 创建日期 | 2025-09-05 17:28:44
图页 | 项目名称
comm1 sch.stm32h563_controller_mini

# TestLink to DUT1

## BTB-V03.2-莫斯卡

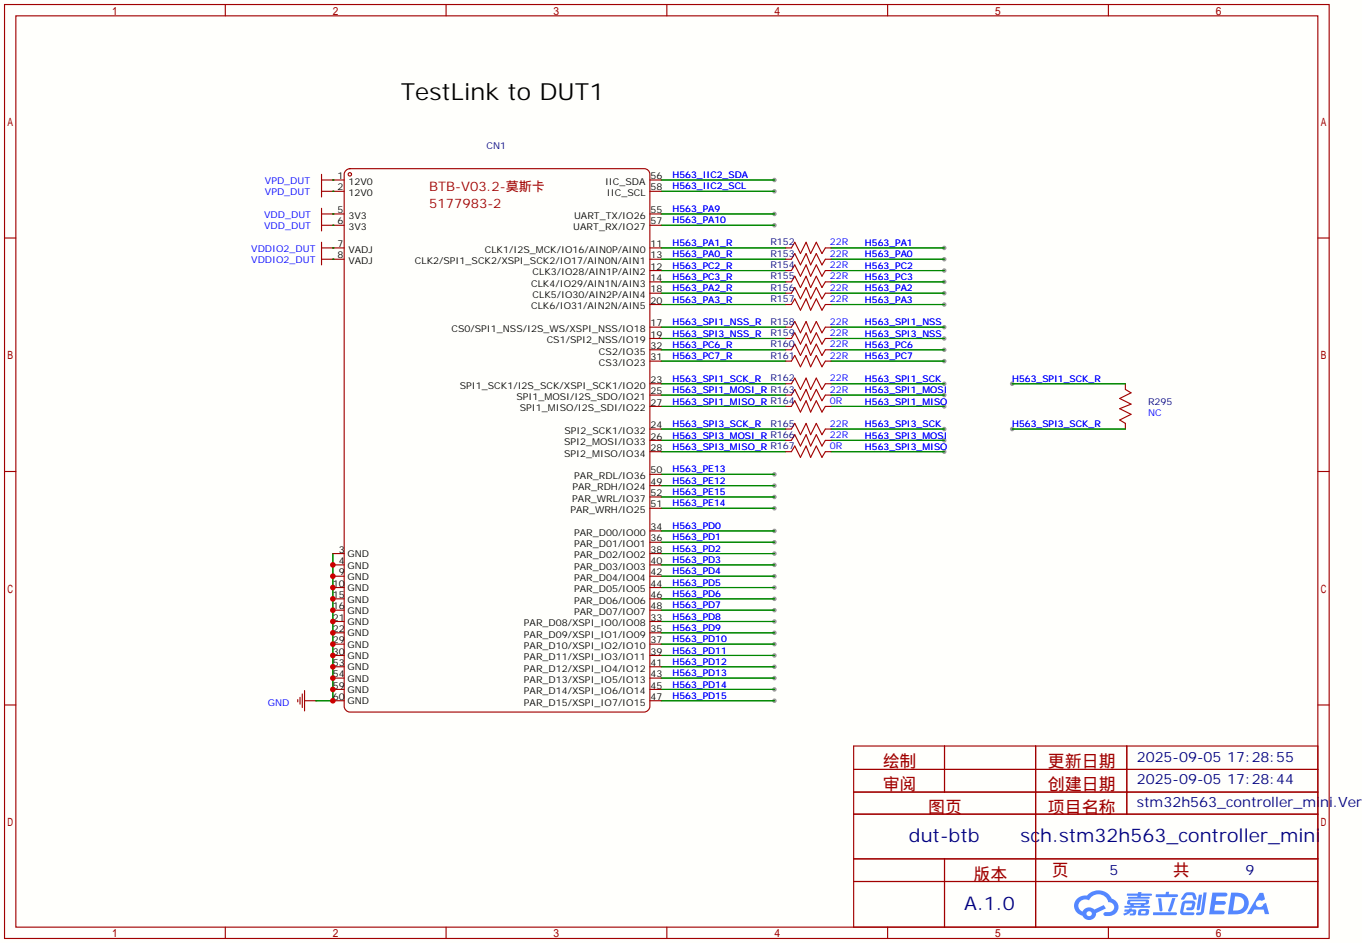
[picture p22: page 5]

绘制 | 更新日期 | 2025-09-05 17:28:55
审阅 | 创建日期 | 2025-09-05 17:28:44
图页 | 项目名称
dut-btb sch.stm32h563_controller_mini

# DUT1

# POWER

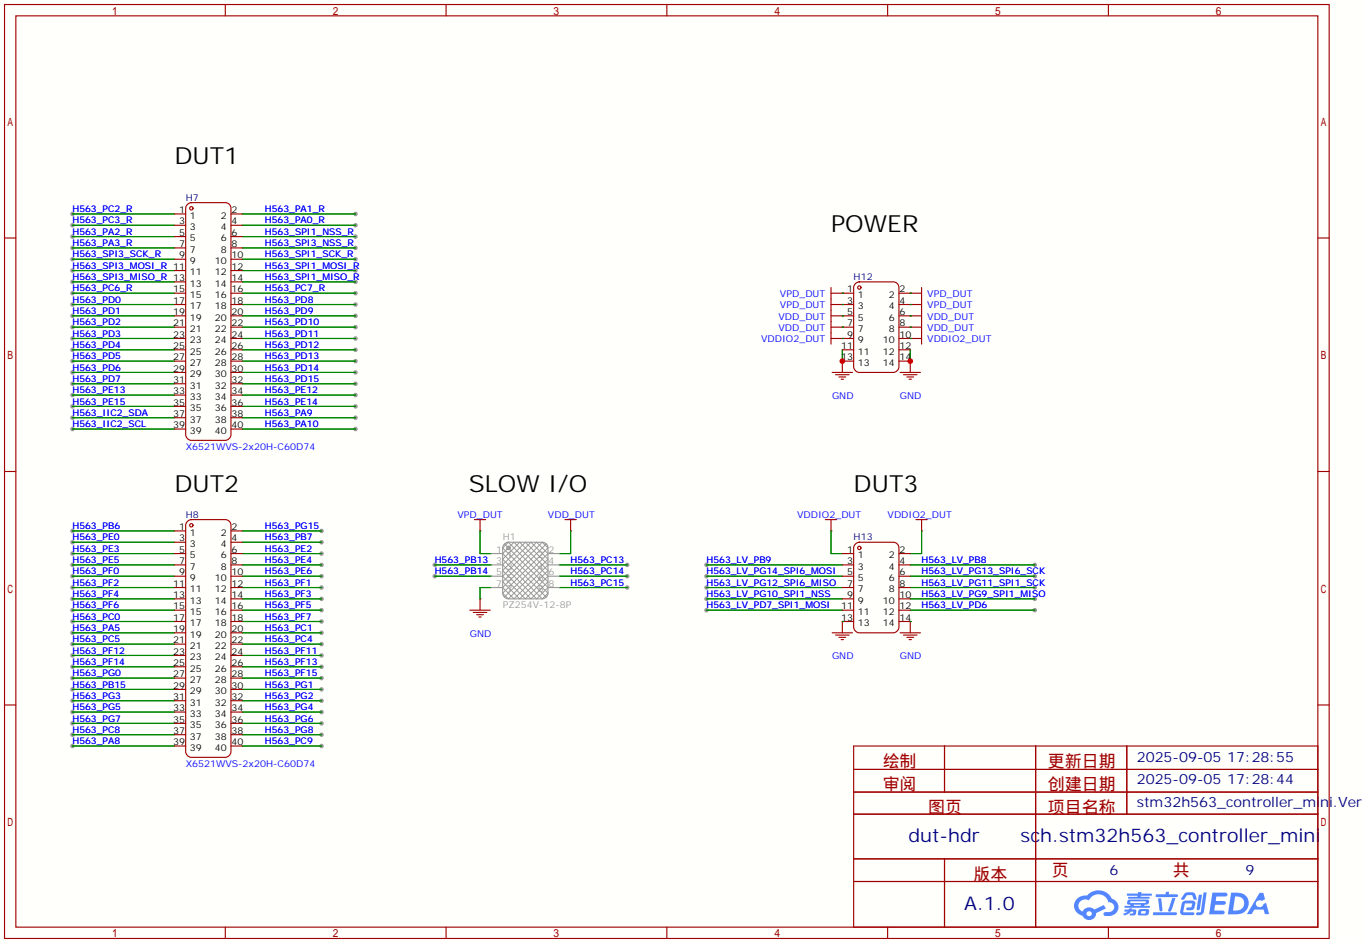
[picture p23: page 6]

绘制 | 更新日期 | 2025-09-05 17:28:55
审阅 | 创建日期 | 2025-09-05 17:28:44
图页 | 项目名称
dut-hdr sch.stm32h563_controller_mini

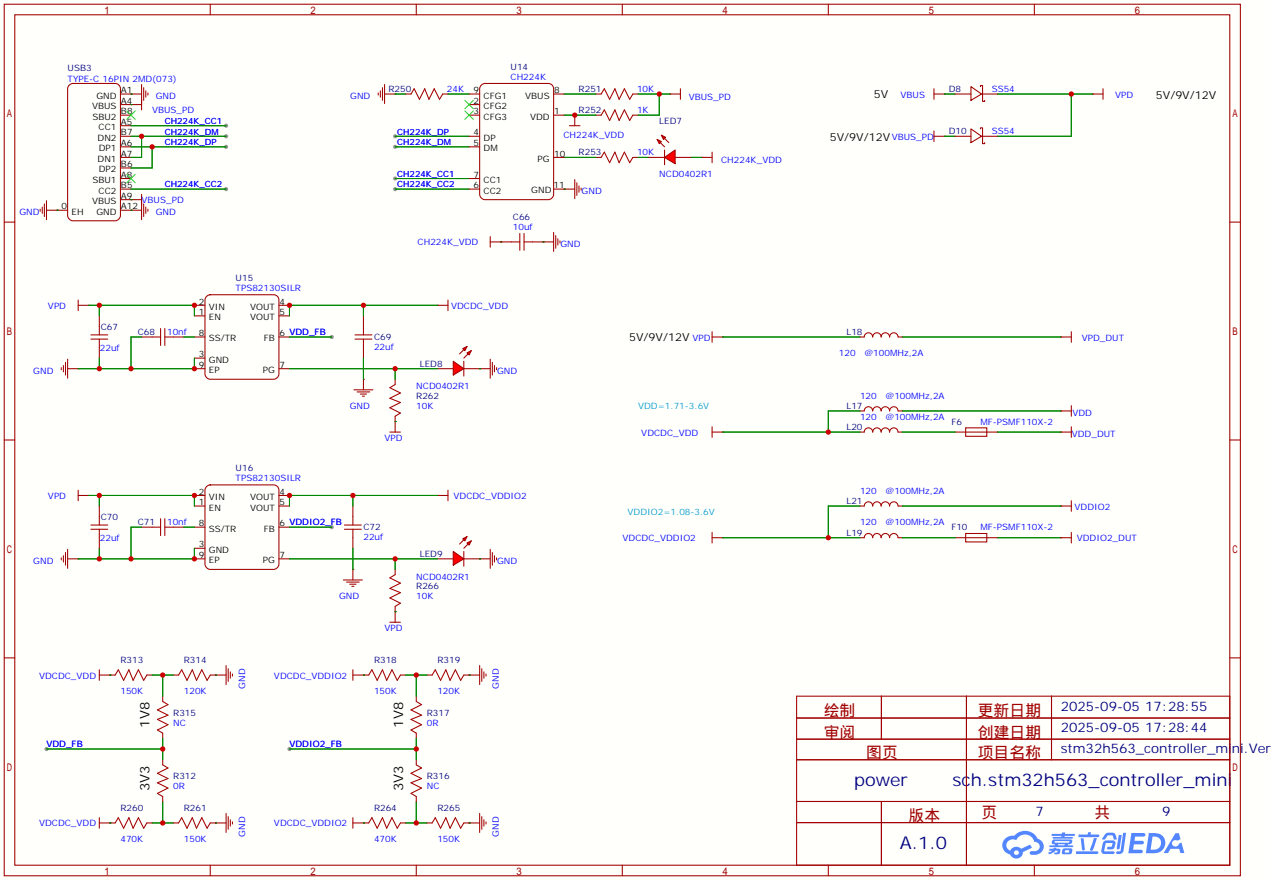
[picture p24: page 7]

绘制 | 更新日期 | 2025-09-05 17:28:55
审阅 | 创建日期 | 2025-09-05 17:28:44
图页 | 项目名称
power sch.stm32h563_controller_mini

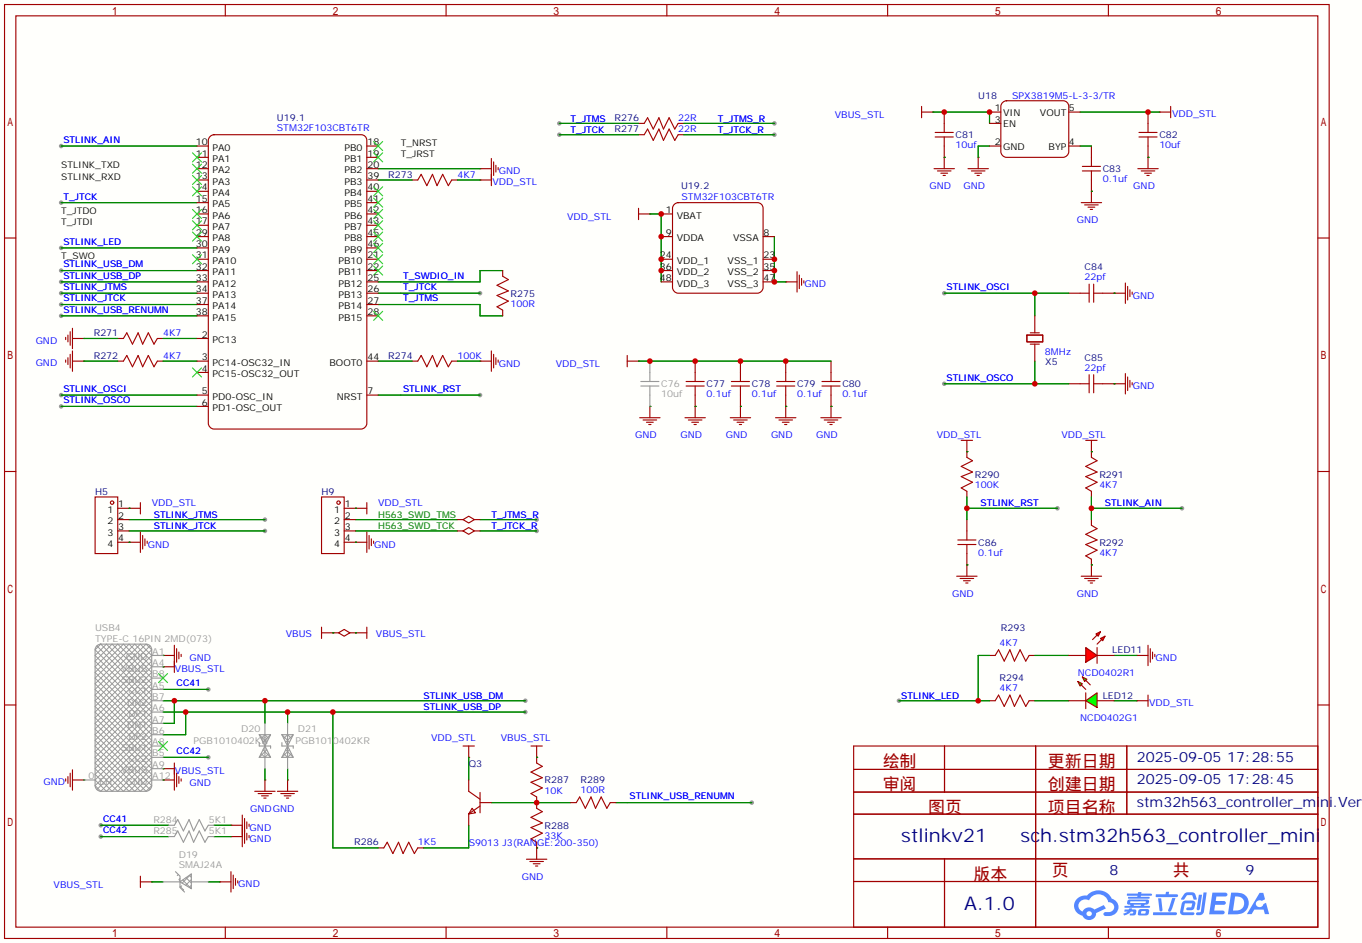
[picture p25: page 8]

绘制 | 更新日期 | 2025-09-05 17:28:55
审阅 | 创建日期 | 2025-09-05 17:28:45
图页 | 项目名称
stlinkv21 sch.stm32h563_controller_mini

## USB3

## USB1

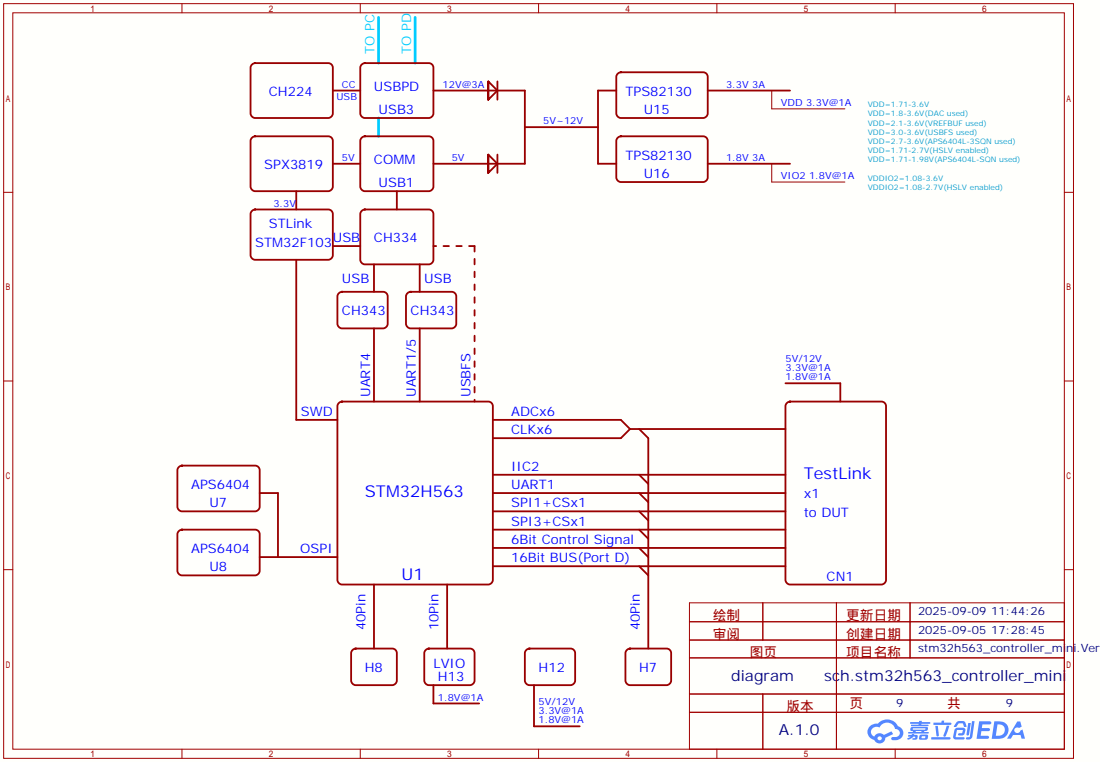
[picture p26: page 9]

绘制 | 更新日期 | 2025-09-09 11:44:26
审阅 | 创建日期 | 2025-09-05 17:28:45
图页 | 项目名称
diagram sch.stm32h563_controller_mini
