CRThu/CarrotController/stm32h563_mini_firmware/Core/Src/main.c

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
/* Includes ------------------------------------------------------------------*/
#include "main.h"
#include "gpdma.h"
#include "i2c.h"
#include "icache.h"
#include "memorymap.h"
#include "octospi.h"
#include "tim.h"
#include "usart.h"
#include "gpio.h"

/* USER CODE BEGIN Includes */
#include "bsp_init.h"
#include "template_func.h"

/* USER CODE END Includes */


void SystemClock_Config(void);
/* USER CODE BEGIN 0 */
void tim5_callback(TIM_HandleTypeDef* htim)
{
    // printf("tim5_callback() called.\r\n");

    write_msg("tim5_callback() called.\r\n");
}


int8_t command_proc(comm_t* comm)
{
    if (comm == NULL)
        return -128;

    uint8_t recv_bytes[256];
    uint16_t recv_len = 0;

    dynpool_t pool;

    //printf("[INFO]: waiting for command\r\n");
    recv_len = comm->read(comm->handle, recv_bytes, sizeof(recv_bytes));
    if (recv_len != 0)
    {
        if (recv_len == (uint16_t)UART_RINGBUF_READ_BUF_OVF)
        {
            printf("[ERROR]: A command was dropped because it was too long, error code = %d.\r\n", recv_len);
            return UART_RINGBUF_READ_BUF_OVF;
        }
        else if (recv_len == (uint16_t)UART_RINGBUF_IS_NOT_CIRCULAR)
        {
            printf("[ERROR]: DMA config is not circular mode, error code = %d.\r\n", recv_len);
            return UART_RINGBUF_IS_NOT_CIRCULAR;
        }

        printf("[INFO]: recv_len=%d.\r\n", recv_len);
        char* cmd = (char*)recv_bytes;
        int8_t status = cmdparse_from_string(&pool, cmd, &recv_len);
        if (status == CMDPARSE_OK)
        {
            printf("[INFO]: cmdparse from string ok.\r\n");
            comm->write(comm->handle, recv_bytes, recv_len);
            dyncall_status_t status = invoke_by_cmd(&pool);
            return status;
        }
        else
        {
            printf("[ERROR]: cmdparse from string err, error code = %d.\r\n", status);
            //comm->write(comm->handle, recv_bytes, recv_len);
            return -127;
        }
    }
    return 0;
}
/* USER CODE END 0 */

/**
  * @brief  The application entry point.
  * @retval int
  */
int main(void)
{

  /* MCU Configuration--------------------------------------------------------*/

  /* Reset of all peripherals, Initializes the Flash interface and the Systick. */
  HAL_Init();

  /* Configure the system clock */
  SystemClock_Config();

  /* Initialize all configured peripherals */
  MX_GPIO_Init();
  MX_GPDMA2_Init();
  MX_ICACHE_Init();
  MX_TIM6_Init();
  MX_OCTOSPI1_Init();
  MX_UART4_Init();
  MX_I2C2_Init();
  /* USER CODE BEGIN 2 */

    bsp_init();
    register_rpc_group(&template_func_group);

    write_msg("helloworld\r\n");

    // printf test
    //printf("[DEBUG]: IO RETARGET TEST\r\n");
    //printf("[INFO]: --- STM32H563ZIT6 TESTING CONTROL PROGRAM ---\r\n");
    //printf("[INFO]: FIRMWARE COMPILE TIME: %s %s\r\n", __DATE__, __TIME__);

    // tim callback resigter and open
    //HAL_TIM_RegisterCallback(&htim5, HAL_TIM_PERIOD_ELAPSED_CB_ID, tim5_callback);
    //HAL_TIM_Base_Start_IT(&htim5);

  /* USER CODE END 2 */

  /* Infinite loop */
  /* USER CODE BEGIN WHILE */
    while (1)
    {
        cdelay_ms(1);

        command_proc(default_comm);

    /* USER CODE END WHILE */

    /* USER CODE BEGIN 3 */
    }
  /* USER CODE END 3 */
}

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
