CRThu/CarrotController/stm32h563_mini_firmware/stm32h563_mini_firmware.ioc

Mcu.UserName=STM32H563ZITx
PA11.Signal=UART4_RX
PA12.Signal=UART4_TX
PA13(JTMS/SWDIO).Signal=DEBUG_JTMS-SWDIO
PA14(JTCK/SWCLK).Signal=DEBUG_JTCK-SWCLK
PA15(JTDI).Signal=SPI3_NSS
PA4.Signal=SPI1_NSS
PA6.Signal=OCTOSPI1_IO3
PA7.Signal=OCTOSPI1_IO2
PB0.Signal=OCTOSPI1_IO1
PB1.Signal=OCTOSPI1_IO0
PB10.Signal=I2C2_SCL
PB12.Signal=I2C2_SDA
PB2.Signal=OCTOSPI1_CLK
PB3(JTDO/TRACESWO).Signal=SPI1_SCK
PB4(NJTRST).Signal=SPI1_MISO
PB5.Signal=SPI1_MOSI
PC10.Signal=SPI3_SCK
PC11.Signal=SPI3_MISO
PC12.Signal=SPI3_MOSI
PE10.Signal=OCTOSPI1_IO7
PE11.Signal=OCTOSPI1_NCS
PE7.Signal=OCTOSPI1_IO4
PE8.Signal=OCTOSPI1_IO5
PE9.Signal=OCTOSPI1_IO6
PF10.GPIO_Label=KEYA
PF10.Signal=GPIO_Input
PF8.GPIO_Label=LEDA
PF8.Signal=GPIO_Output
PF9.GPIO_Label=LEDB
PF9.Signal=GPIO_Output
PH0-OSC_IN(PH0).Signal=RCC_OSC_IN
PH1-OSC_OUT(PH1).Signal=RCC_OSC_OUT
