CRThu/CarrotController/(commit log)

2025-01-21 add timer and uart dma
2025-01-21 update led and uart comm
2025-01-21 创建结构体
2025-01-22 create bsp and framework files
2025-02-14 update uart_comm
2025-02-24 dac11001运行成功版本
2025-02-25 use hardware spi nss
2025-02-25 dac11001 dds调试完成
2025-02-25 工程结构优化
2025-03-27 调整项目文件路径
2025-03-27 update ad7616 driver framework
2025-04-01 ad7616 driver
2025-04-01 update sample test
2025-04-02 tim spi 恢复默认状态
2025-04-03 spi io init
2025-04-03 use spi without cubemx test
2025-04-07 项目结构还原
2025-04-07 update spi init
2025-04-07 update pll+spi clock
2025-04-07 update spi
2025-04-07 generate spi register callback
2025-04-07 ser模式调试通信可发送
2025-04-07 update spi initial
2025-04-08 update spi config
2025-04-08 spi update
2025-04-08 ad7616串行模式通信
2025-04-08 update ft driver
2025-04-09 update uart
2025-04-10 timer update
2025-04-10 update pwm
2025-04-10 update ad7616 pwm
2025-05-20 串口调用测试
2025-05-23 update cevent and timer
2025-08-06 update v2, add switch
2025-08-07 update uart comm
2025-09-11 项目拆分
2026-03-05 feat: add namespace support to register and bitfield RPC
    Updated the CARROT RPC protocol to version 1.2.3, introducing an optional namespace (file) parameter for register and bitfield access. This allows distinguishing between different register groups or peripheral base addresses in the ASCII communication protocol.
    Changes:
    - Updated CARROT_RPC.md documentation with new syntax and examples.
    - Modified reply_reg and reply_bits function signatures in the C library to accept a file parameter.
    - Updated implementation to handle optional file namespaces in output strings.
    - Added .agentignore to exclude build and driver directories from agent indexing.
2026-03-11 增加函数声明
